grilledbiscuits/smartfeeder/deploy/soak-20261012/README.md

# Pi replay soak, 2026-10-12

This is a **desk replay stability test**, not a field visit or independent
accuracy test. The Pi replays 20 labelled clips through the deployed 37-class
INT8 classifier for 72 cycles at 30-second intervals (1,440 events planned).
The ToF sensor is unpowered; the camera is not used by the replay runner.

- `pilot/`: complete one-cycle check, 20 events, 0 errors. All three files were
  checked before the full run began.
- `checkpoint/`: a snapshot of the **still-running** full soak at 14:31:44 SAST,
  460 events, 0 errors. Do not quote it as a completed 12-hour result.
- `events.jsonl`: one row per event, including processing time, memory, temperature,
  clock, throttle flags, classification, and action outcome.
- `status.json`: run state, counts, and SHA-256 hashes of the model, config,
  calibration, taxonomy, replay manifest, and runner.
- `runner.log`: startup warnings and uncaught errors from the process.

## Completed run

The full soak completed: 1440 events, 0 runtime errors, 1368 correct identifications, and 1440 correct actions. `full/` contains the complete event log, status, and runner log. Repeated clips test stability, not independent accuracy.

Camera latency results and measurement code are in `latency/`. No USB-C power measurement was available from this laptop.
