grilledbiscuits/smartfeeder/YNSJAC001_EEE4022S_Project_Report/2_Preface/1_Acknowledgements.tex

\phantomsection
\prefacesection{Acknowledgements}

% INSERT YOUR ACKNOWLEDGEMENTS %
%I would like to acknowledge my parents and friends. This thesis, a manifestation of the many sleepless nights, would not have been possible without their support. This section highlights your acknowledgment of individuals whom you believe deserve recognition for their contribution towards making your achievement possible.  

\clearpage % keep this for proper page numbering!
