grilledbiscuits/smartfeeder/YNSJAC001_EEE4022S_Project_Report/2_Preface/2_PlagiarismDeclaration.tex

\phantomsection
\prefacesection{Plagiarism Declaration}

    \begin{enumerate}
        \item I know that plagiarism is wrong. Plagiarism is to use another's work and pretend that it is one's own.
        \item I have the IEEE convention for citation and referencing. Each contribution to, and quotation in, this final year project report from the work(s) of other people, has been attributed and has been cited and referenced.
        \item This final year project report is my own work.
        \item I have not allowed, and will not allow, anyone to copy my work with the intention of passing it off as there own work or part thereof.
    \end{enumerate}

    \vspace{15mm}

    \mbox{}\hfill\begin{minipage}{65mm} % No need to change this part
      \dotfill\\[1ex]%
      \Author\\
      \today
    \end{minipage}
    
    \vfill\vfill\vfill
