grilledbiscuits/smartfeeder/YNSJAC001_EEE4022S_Project_Report/5_Appendices/Appendix_B/Appendix_B.tex

\chapter{Satirical Support}

This section provides some comic relief. In addition, it serves as an example of how to insert an image into your thesis with proper caption, label and citation.

\begin{figure}[ht]
	\centering
	
	\caption{You must prepare to defend your thesis.}
	\label{fig:DEFENCE}
\end{figure}

\clearpage
