grilledbiscuits/smartfeeder/ml/ASSUMPTIONS.md

# Assumptions

Things I have assumed, inferred, or could not verify — collected here rather
than buried in comments. **Each needs your confirmation.** Ordered by how much
damage a wrong assumption would do.

Legend: 🔴 blocks or invalidates results · 🟡 shapes design · 🟢 minor

---

## 🔴 A1. The sex head is data-starved, and it is exactly where you said it would hurt

Measured against the live iNaturalist API on 2026-07-31 (research grade, South
Africa, with photos):

| Species | Observations | Male | Female | Sex-annotated |
|---|---|---|---|---|
| *Cinnyris chalybeus* | 6203 | 530 | **161** | 11.2% |
| *Anthobaphes violacea* | 3617 | 885 | 207 | 30.2% |
| *Nectarinia famosa* | 4405 | 606 | 202 | 18.4% |
| *Promerops cafer* | 4701 | 186 | **59** | 5.3% |
| *Chalcomitra amethystina* | 3526 | 591 | 295 | 25.3% |
| *Cinnyris afer* | 3021 | 512 | **108** | 20.5% |

Only 5–30% of observations carry a Sex annotation, and males outnumber females
roughly 3:1 — photographer bias toward bright breeding males.

**Consequence:** after dedup and a grouped split, female *C. chalybeus* and
female *C. afer* yield roughly 16–24 test images each. That is not enough to
settle whether they are separable. The Phase 5 fast loop will report
"insufficient data to decide" for these classes rather than a verdict (D11).

**This is the project's binding constraint — not the architecture.** The
photographs exist; the annotations do not. If you want the merge question
actually answered this round, manually sexing a few hundred existing images is
by far the highest-value use of your time. Phase 5 will quantify exactly how
many per class.

**Please confirm:** should the pipeline include a labelling-assist export
(uncertainty-ranked crops, ready to sex) as part of Phase 5 rather than waiting
for Phase 8?

## 🔴 A2. No source annotates eclipse plumage

The iNaturalist Sex controlled term has exactly three values (Male, Female,
Cannot Be Determined) and Life Stage offers Adult and Juvenile. GBIF's `sex`
field is binary. Wikimedia and Flickr have no structured annotation at all.

I have therefore assumed `male_breeding` vs `male_eclipse` **cannot be sourced
automatically at all**, and implemented the masked partial-label loss (D3)
instead of fabricating labels.

**Please confirm:** is that acceptable, or do you have another source in mind?
The Macaulay Library request (Phase 2) is the realistic route to real plumage
annotations — their media *is* annotated for age and sex — which is why the
draft email matters more than it might appear.

## 🔴 A3. There is a git repository over your entire home directory

`/home/grilledbiscuits/.git` exists with zero commits, and tracks nothing yet.
It looks like an accidental `git init`.

I did not touch it, and gave `smartfeeder/` its own repository instead (D1).

**This is a standing hazard:** a stray `git add -A` run from your home directory
would stage `.ssh/` private keys, `.gnupg/`, `.claude.json`, browser profiles and
Thunderbird mail. **Recommend you delete it** (`rm -rf ~/.git`) once you have
confirmed it holds nothing you want — but that is your call to make, not mine.

## 🟡 A4. GBIF places the Fiscal Flycatcher in *Sigelus*, not *Melaenornis*

`GET /species/match?name=Melaenornis silens` returns `Sigelus silens`, genus
*Sigelus*, matchType EXACT (via synonymy). Family is Muscicapidae either way, so
rollup is unaffected.

I kept **Melaenornis silens** in `species.yaml` — current IOC usage and the name
you supplied — and will record GBIF's own genus separately during resolution.
`taxa.py` will treat a derived-genus/backbone-genus mismatch as a warning
requiring an explicit acknowledgement, not a silent pass.

**Please confirm** you are happy retaining the IOC name.

## 🟡 A5. Rollup thresholds are placeholders

`species: 0.55, genus: 0.65, family: 0.75, guild: 0.80` in `taxonomy.yaml` are
**guesses**, chosen only to be monotonically increasing with generality. They
are not derived from anything.

Phase 7 populates `per_class_thresholds` from real precision-recall curves. Do
not read anything into the current values.

## 🟡 A6. Class-size policy numbers are judgement calls

`min_species_images: 100` (fold into genus), `warn_species_images: 250`,
`min_test_images_for_verdict: 50`. Reasoned but not empirical — the 100 figure
matches the threshold you asked to be flagged in the Phase 2 report.

Under this policy, *A. reichenowi* (33 global) and *C. neergaardi* (32 global)
will certainly fold into `anthreptes_indet`… except *Anthreptes* is a
single-species genus here, so they fold to `nectariniidae_indet` instead. Worth
knowing before you see it happen.

## 🟡 A7. Monomorphic species list is from general ornithological knowledge

`monomorphic_forced_na` in `taxonomy.yaml` lists 13 Tier C species plus both
*Cyanomitra* as visually monomorphic, forcing their sex label to
`not_applicable` so the head is not trained on noise.

This is **my knowledge, not a cited source**. *Cyanomitra veroxii* and
*C. olivacea* in particular are worth a second look — they show subtle
dimorphism that a field guide would list even if a feeder camera could not
resolve it. You are far better placed to check this list than I am.

## 🟢 A8. Local fast-loop backbone choice

`convnext_tiny.in12k_ft_in1k` was chosen as a CPU-feasible compromise. I have
**not** benchmarked its extraction throughput on this machine — the 30–45 min
estimate for 20k images is from your brief, not measured. Phase 5 will measure
it and report the real figure.

## 🟢 A9. `max_images_per_species: 1500`

Caps the head of the distribution so *C. chalybeus* does not swamp training.
Arbitrary. Interacts with class-balanced sampling and focal loss, both of which
Phase 6 reports on, so it can be revisited with evidence.

## 🟢 A10. Augmentation parameters are unvalidated

Motion blur kernel 3–11px, occlusion up to 30% area, JPEG quality 30–75. Chosen
to mimic the deployment failure modes you described. Until real feeder captures
exist there is nothing to validate them against — the domain gap remains the
project's largest technical risk, and these numbers are a hypothesis about it.

---

## 🔴 A11. First real scores: females are worse, but not in the way expected

Vertical slice, 2026-08-01. Tier A only (6 species), 3,573 images after dedup,
linear probe on frozen `convnext_tiny.in12k_ft_in1k` features. Taxon accuracy
**0.684** [95% CI 0.644-0.722]. Test recall broken out by sex:

| Species | Sex | n | Recall | 95% CI |
|---|---|---|---|---|
| *C. chalybeus* | male | 57 | 0.544 | 0.42-0.67 |
| *C. chalybeus* | female | 39 | 0.359 | 0.23-0.52 |
| *C. afer* | male | 63 | 0.667 | 0.54-0.77 |
| *C. afer* | female | 28 | 0.250 | 0.13-0.43 |

The male/female gap is real — the CIs for male and female *C. afer* do not
overlap. But **where the errors go differs by sex**, and that was not expected:

- **Male** errors concentrate on the sibling species (male *chalybeus* → *afer*
  14 of 26 errors; male *afer* → *chalybeus* 14 of 21).
- **Female** errors scatter across all species (female *chalybeus* → *afer* 11,
  *famosa* 7, *amethystina* 5; female *afer* → *chalybeus* 6, *violacea* 5,
  *famosa* 4).

**This matters for the merge decision.** Merging *C. chalybeus* and *C. afer*
into `cinnyris_double_collared_indet` would recover most *male* errors but only
about a third of *female* errors. The female problem is not primarily
sibling confusion — it looks like weak features from drab plumage. **Merging
would not fix it.**

Both female classes fall below `min_test_images_for_verdict: 50`, so the
pipeline correctly refuses to issue a merge verdict. Treat the above as a
direction, not a conclusion.

**Caveats, all of which inflate or deflate this number:**
- Linear probe on ImageNet features, not a fine-tune. A real fine-tune should
  improve absolute accuracy substantially.
- Six classes only. No Tier C, so the false-positive question is untested.
- The corpus over-samples annotated observations (D12), so it is harder than the
  wild distribution — the 0.684 is pessimistic as a deployment estimate and
  meaningless as a class-prior estimate.
- Still web photographs. The feeder-camera domain gap is entirely unmeasured.

---

## 🔴 A12. CORRECTION to A11 — merging the double-collared pair IS now justified

A11 concluded, on 3,573 images, that merging *C. chalybeus* and *C. afer* "would
not fix" the female problem because female errors scattered rather than
concentrating on the sibling. **With 9,318 images that conclusion is wrong and
is withdrawn.**

Measured on `tf_efficientnetv2_b0`, test split:

| | before merge | after merge | gain |
|---|---|---|---|
| overall | 0.727 | 0.786 | +5.9pp |
| **females only** (n=276) | 0.551 | 0.630 | **+8.0pp** |
| males only (n=758) | 0.785 | 0.846 | +6.1pp |

45% of all errors on the double-collared pair are mutual confusion between the
two. Merging now helps females **more** than males, the reverse of A11.

What changed is sample size, not the model. The earlier female error counts
(11 and 6) were too small to distinguish "scattered" from "concentrated"; at
n=48–58 per class the concentration is clear. This is precisely the failure mode
`min_test_images_for_verdict` exists to prevent, and I drew a conclusion from
under-powered data anyway. Treat A11's directional claim as retracted.

**Recommendation:** add `cinnyris_double_collared_indet` as a merged class and
let the rollup emit it when neither species clears its threshold. This is the
brief's "correct outcome, not a failure" case.

## 🔴 A13. *Cinnyris afer* is the single worst Tier A class

Female recall 0.208 (`tf_efficientnetv2_b0`) and 0.167 (`convnext_tiny`), against
0.552/0.621 for female *C. chalybeus*. The errors are overwhelmingly one-way:
female *afer* → *chalybeus* (18 and 23 respectively), not the reverse.

The classifier is collapsing *afer* into *chalybeus*. That asymmetry suggests a
prior/imbalance effect on top of genuine visual similarity, so class-balanced
sampling and focal loss (both already configurable, Phase 6) should be evaluated
against it specifically before concluding the pair is inseparable.

## 🟡 A14. EfficientNetV2 Hailo compatibility is UNVERIFIED

`tf_efficientnetv2_b0` uses fused-MBConv blocks and squeeze-excite. Both are
standard convolutional constructs and should compile, but **I have not run the
Hailo Dataflow Compiler** — it is an x86 toolchain requiring a Developer Zone
account, and is not installed here.

If it turns out SE blocks compile poorly on the Hailo-8L, `efficientnet_b0`
(0.39G MACs, 0.691 taxon) and `mobilenetv3_large_100` (0.21G, 0.690) are the
fallbacks, at roughly -4pp taxon and -4 to -8pp female. Worth compiling all
three early rather than discovering this at deployment.

## 🟡 A15. More data helped substantially — and is probably still helping

Tier A taxon accuracy on `convnext_tiny` went **0.684 → 0.788** when the corpus
grew 3,573 → 9,318 images (+10.4pp for 2.6x data). The curve has not visibly
flattened.

The cap is now `max_images_per_species: 1500`, and several species hit it. Raising
it is the cheapest remaining accuracy lever — cheaper than any architecture
change measured so far — though it will not help the *sex* head, which is
limited by annotation availability, not photograph availability.

---

## 🔴 A16. Adding Tier C cost Tier A accuracy — as expected, and it was worth it

With Tier A alone (6 classes): Tier A macro recall **0.735**, female **0.577**.
With Tier C added (24 classes): Tier A macro recall **0.686**, female **0.471**.

That is −4.9pp on Tier A and −10.6pp on females. The drop is real and is the
price of the model being *able* to say "not a sunbird". The earlier Tier-A-only
number was flattering because the model was never asked to reject anything.

What Tier C buys, measured on the test split:

* Tier C bird called a nectarivore: **9.4%** [7.9–11.1]
* Tier A bird called a non-target: **10.4%** [8.9–12.1]

Worst offender by a distance: **Speckled Mousebird (*Colius striatus*), 40%
called a nectarivore** (n=60). Plausible — long tail and slender body read like a
Cape Sugarbird. Karoo Prinia (18.5%) and Cape Bulbul (17.6%) follow.

**Recommendation:** *Colius striatus* needs more data before deployment; at 40%
it is a live false-positive source at a Cape Town feeder, where mousebirds are
common.

## 🔴 A17. The OOD evaluation set is missing its most common members

`config/ood.yaml` covers animals. Real feeder footage will be dominated by
things iNaturalist cannot supply, because nobody uploads them as wildlife
observations:

* **empty feeder** — by far the most common motion trigger
* **rain, blown leaves, moving shadows, lens flare**
* **human hands and faces** (refilling the feeder; *Homo sapiens* has 0
  research-grade ZA records)

So the 90.9% catch rate is measured against the *animal* subset of the problem
only. It is necessary evidence, not sufficient. **The first week of real capture
data should be used to re-measure this**, and those frames are exactly what the
`unknown` log will collect automatically.

## 🟡 A18. Weakest OOD classes are the ones that matter most at a feeder

Per-taxon catch rate at 5% false alarm:

| taxon | caught |
|---|---|
| Agama atra | 0.982 |
| Trachylepis capensis | 0.974 |
| Rattus rattus / Papio ursinus / Felis catus | 0.955–0.958 |
| Papilio demodocus | 0.952 |
| **Sciurus carolinensis** (grey squirrel) | **0.930** |
| Apis mellifera | 0.916 |
| **Rhabdomys pumilio** (grass mouse) | **0.816** |
| **Xylocopa caffra** (carpenter bee) | **0.794** |

The two weakest are both small animals photographed at flowers — the same
context, scale and background as a feeding sunbird. Carpenter bees in particular
*share the feeder*, so they will be over-represented in real triggers relative to
this evaluation set. Expect the real-world figure to be worse than 90.9%.

## 🟡 A19. The 5% false-alarm rate is a placeholder

`target_false_alarm_rate: 0.05` means 5% of genuine bird frames are discarded as
unknown. End to end that yields: 69.1% of real bird frames trigger capture, 4.0%
of intruder frames do.

This is an operator preference, not a derived value. Track-level voting also
softens it — a visit yields many frames and only needs some to pass. Revisit once
you know whether you would rather miss visits or store squirrels.

---

## 🔴 A20. False triggers are close to solved. Confidence on real birds is not.

**CORRECTED 2026-08-05.** This entry previously claimed 22.9% of bird visits and
0.4% of OOD visits trigger. Those figures were stale: `reports/operating_points.json`
had been regenerated and the prose was never updated. The numbers below are read
directly from that file, at the stated operating point (novelty FAR 15%,
per-class thresholds fitted for 80% precision):

* **OOD visits that trigger a capture: 1.3%.** At 30% FAR it is 0.6%.
* **Real bird visits that trigger a capture: 41.95%** (224 of 534 test visits).

Two things make even that figure hard to interpret, so treat it as an upper
bound on the problem rather than a measurement:

1. **The denominator is contaminated.** `frame_triggers` only checks Tier A
   class thresholds, but the rate is computed over every in-distribution test
   visit. 234 of the 534 (43.8%) are Tier C and cannot fire by construction, so
   the metric's ceiling is 56.2%, not 100%. Against the 300 Tier A visits, 224
   fires is 74.7% — but fired-frame precision is 0.868, so some of those are
   Tier C birds misread as Tier A. The true Tier A trigger rate lies somewhere
   between 42% and 75%.
2. **The metric does not execute production inference.** It fires when any Tier A
   probability crosses its threshold even if that class is not the argmax, and
   it uses "any frame fires" rather than `Classifier.vote()`. `should_record`
   meanwhile fires on *any* species- or genus-level result, including Tier C.

**So the size of this problem is currently unknown.** It is smaller than the
22.9% figure that drove planning through 2026-08-04, and it may not be a problem
at all. Resolving it requires an evaluation path that calls `decide()`, `vote()`
and `should_record` on the real checkpoint. See RUNNING.md.

What the FAR sweep does show clearly is a real trade: moving 2% → 15% FAR costs
6.7pp of bird visits (48.7% → 42.0%) to gain 6.3pp on OOD (7.6% → 1.3%). The
novelty gate and the classifier are competing, and they were fitted
independently. A joint re-tune remains the cheapest available lever.

The cause is that frozen-feature confidence is poor on the hardest classes. At a
90% precision target the double-collared sunbirds only fire on 3–9% of their
frames; relaxing to 80% gets them to 20–37%:

| Tier A species (80% target) | threshold | test precision | recall |
|---|---|---|---|
| Amethyst Sunbird | 0.41 | 0.881 | 0.601 |
| Nectarinia famosa | 0.69 | 0.875 | 0.477 |
| Cinnyris afer | 0.56 | 0.841 | 0.406 |
| Anthobaphes violacea | 0.51 | 0.831 | 0.729 |
| Promerops cafer | 0.32 | 0.759 | 0.811 |
| **Cinnyris chalybeus** | **0.82** | **0.742** | **0.223** |

***Cinnyris chalybeus* is the worst case and also the most likely visitor** —
the commonest sunbird at a Cape Town feeder is the one the model is least
confident about. It cannot reach 80% precision at any threshold, and at 0.82 it
fires on under a quarter of its frames.

**The fix is not more thresholding.** These numbers come from a linear probe on
frozen ImageNet features; the ceiling is set by the features, not the head.

**Confirmed 2026-08-05.** The full fine-tune ran 20 epochs on CPU (5.3 h) and
lifted val taxon accuracy from 0.684 to 0.7875 with Tier A macro-recall 0.7782
at the selected epoch 16. The diagnosis was right: the features were the ceiling.

**But none of the per-class numbers in the table above have been recomputed on
the fine-tuned model.** Until 2026-08-05, `eval/` loaded frozen sweep embeddings
and never read a checkpoint, so re-running it would have reported the pre-fine-tune
model under the new model's name. `eval/extract.py` now exists to close that gap;
this table stands only until it is rerun.

## 🟡 A21. "Highly likely visitor" is not yet encoded anywhere

The range prior exists in `inference.py` and is **empty**. Nothing currently
tells the model that a Cape Town feeder sees six species routinely and
*Cinnyris neergaardi* essentially never.

Populating it would raise precision on the real visitors for free — no
retraining, one config block. It needs your input, though: the weights should
reflect what your feeder actually sees, and I would be guessing. A first pass
could come from iNaturalist observation density within ~25km of the site.

---

## 🔴 A22. INT8 quantisation costs 5.1 accuracy points — not free

Measured 2026-08-04 on 800 test images, against a genuinely trained model
(backbone + frozen-feature heads, standardisation folded into the linear layer).
MinMax calibration, per-channel weights, 500 calibration images from train.

* **24.4 MB → 7.5 MB** (3.3x smaller)
* **accuracy 0.641 → 0.590 (−5.1pp)**
* the two models agree on only 72.2% of test images

Five of six Tier A classes degraded past the 2% flag threshold:

| class | FP32 | INT8 | delta |
|---|---|---|---|
| *Chalcomitra amethystina* | 0.714 | 0.607 | −10.7pp |
| *Anthobaphes violacea* | 0.803 | 0.697 | −10.6pp |
| *Promerops cafer* | 0.820 | 0.746 | −7.4pp |
| *Cinnyris afer* | 0.509 | 0.456 | −5.3pp |
| *Cinnyris chalybeus* | 0.554 | 0.523 | −3.2pp |

This is exactly the failure the brief predicted: nearly-identical classes sit
close together in feature space and INT8 smears them, **unevenly**. An averaged
delta would have hidden that *amethystina* and *violacea* took the worst of it.

**Not yet exhausted.** Only MinMax calibration was measured. Percentile and
Entropy calibration are usually kinder to outlier activations and often recover
much of the loss; that comparison was started and interrupted, and is the first
thing to finish. Mixed precision — keeping the final layers in FP32 — is the
next lever after that.

**Do not ship INT8 on these numbers.** If the board turns out to be a Pi 5 with
the AI HAT+, quantisation is mandatory anyway and this becomes a hard constraint
to engineer around. If it is a Pi 4B, it is a speed/accuracy dial you control.

## 🟡 A23. The first export with real weights was only just now possible

Every earlier ONNX export carried **randomly-initialised heads** — the graph was
valid, the cost figures were real, but the predictions were noise. Quantising it
measured noise against noise, which I caught only when the reported accuracy came
back at 0.05.

`export_from_frozen_head` now builds a genuinely trained model from the fast-loop
heads, folding the feature standardisation into the linear layer. Anything that
evaluates the exported artefact must use that path until `train_full.py` exists.

## 🔴 A24. RESOLVED — INT8 costs 3–5 accuracy points, and calibration cannot fix it

The matched sweep is done: identical 800-image evaluation set, varying only
calibration size, Percentile calibration.

| calibration images | FP32 | INT8 | delta | INT8 95% CI |
|---|---|---|---|---|
| 32 | 0.6412 | 0.6075 | **−3.4pp** | 0.573–0.641 |
| 64 | 0.6412 | 0.5988 | **−4.2pp** | 0.564–0.632 |
| 500 (MinMax) | 0.6412 | 0.5900 | **−5.1pp** | — |

**Calibration size is not the explanation, and neither is method.** Across 32 to
500 calibration images and across MinMax and Percentile, INT8 costs between 3.4
and 5.1 points. There is no setting in this range that makes it free.

**The +1.6pp result was small-sample noise.** It came from a 250-image
evaluation, where the 95% CI spans roughly ±6 points — wide enough to swallow the
entire effect. Measured on 800 images the same configuration gives −3.4pp. That
is a cautionary result about my own earlier reporting, not about the method.

**Consequence for deployment.** INT8 is a real 3–5 point cost, not a free
optimisation:

* **Pi 5 + AI HAT+** — quantisation is mandatory, so this is a cost to engineer
  around, not a choice. Quantisation-aware training or keeping the final layers
  in higher precision are the remaining levers.
* **Pi 4B (CPU)** — it is a dial you control. Given that only ~23% of genuine
  bird visits currently clear a threshold (A20), spending another 3–5 points on
  speed is probably the wrong trade until confidence improves.

Not attempted: mixed precision, and quantisation-aware training. Both are real
options and both are more work than a calibration flag.

## 🟢 A24b. Superseded note — the original uncertainty

Two runs, not comparable:

| run | calib images | test images | delta |
|---|---|---|---|
| first | 500 | 800 | −5.1pp |
| second | 64 | 250 | −0.8 to +1.6pp |

They differ in **both** variables, so neither explains the gap. And at n=250 the
95% CIs across the three calibration methods overlap almost completely, so that
sweep cannot rank them either.

What would settle it: one evaluation set (ideally the full 2,674 test images),
varying only calibration size, one method per process. That is roughly six
short runs and was not attempted here because each earlier long run was being
OOM-killed. It is now safe to do with the memory guard in place.

Until then, treat INT8 as "probably cheap, possibly costly" and re-measure
before shipping.

## 🔴 A25. Fine-tuning improved classification and *broke* open-set detection

Measured 2026-08-05 on `student_best.pt` (epoch 16), test set n=2,674 in-distribution
and 2,486 OOD, via `eval/extract.py` + `eval/thresholds.py --checkpoint`.

**Classification improved on every axis.** Temperature fell from 2.332 to **0.986** —
the fine-tuned model is essentially calibrated as trained and needs almost no
softening. Per-class recall at the 80% precision target:

| Tier A species | frozen recall | fine-tuned recall | frozen prec | fine-tuned prec |
|---|---|---|---|---|
| Amethyst Sunbird | 0.601 | **0.853** | 0.881 | 0.800 |
| Orange-breasted Sunbird | 0.729 | **0.921** | 0.831 | 0.847 |
| Malachite Sunbird | 0.477 | **0.770** | 0.875 | 0.830 |
| Cape Sugarbird | 0.811 | **0.917** | 0.759 | 0.729 |
| *Cinnyris afer* | 0.406 | **0.641** | 0.841 | 0.781 |
| ***Cinnyris chalybeus*** | 0.223 | **0.386** | 0.742 | **0.833** |

A20 said *C. chalybeus* "cannot reach 80% precision at any threshold". It now
reaches 0.833 at threshold 0.74, with recall up 16pp. That was the headline
problem class and it is substantially better.

**Open-set detection degraded badly.** The kNN novelty scorer refitted on
fine-tuned features:

| scorer | frozen AUROC | fine-tuned AUROC |
|---|---|---|
| kNN | **0.979** | **0.9032** |
| energy | 0.9273 | 0.8318 |
| mahalanobis | — | 0.8752 |
| max_softmax | 0.7139 | 0.7912 |

kNN's catch rate at 5% FPR fell from 0.909 to 0.431. Only max_softmax improved,
and only because the model is now calibrated.

This is representation collapse, and it is expected in hindsight: fine-tuning
specialises the feature geometry to the 22 trained classes and discards the
generic visual structure that made a distance-based novelty test work. The
scorer ranking is unchanged — kNN is still best of the four — but its absolute
performance is not what the deployment assumed.

**End to end this was nearly a wash**, at 15% FAR: bird visits 41.95% → 51.1%,
but OOD visits 1.3% → **11.1%**. Nine points of real birds bought at the price
of ten points of squirrels, against a stated priority of minimising false
triggers.

### The fix is measured and works: split the two jobs

Novelty on **frozen** ImageNet features, classification on the **fine-tuned**
model. Same corpus, same thresholds, same scorer — only the feature space the
kNN sees changes:

| novelty FAR | bird visits (FT feats) | OOD visits (FT feats) | bird visits (FROZEN feats) | OOD visits (FROZEN feats) |
|---|---|---|---|---|
| 5% | 0.560 | 0.274 | **0.569** | **0.061** |
| 10% | 0.530 | 0.163 | **0.549** | **0.020** |
| 15% | 0.511 | 0.111 | **0.521** | **0.015** |
| 20% | 0.485 | 0.056 | **0.496** | **0.011** |

**Better on both axes simultaneously at every operating point.** Against the
original frozen-everything baseline at 15% FAR, the hybrid gives 52.1% of bird
visits versus 41.95% — **+10.2pp** — at 1.5% OOD versus 1.3%, which is inside noise.

**Unresolved: this costs two backbone passes on the Pi.** Both are
`tf_efficientnetv2_b0`, one ImageNet-pretrained and one fine-tuned, so it is
2× inference. Untested cheaper option: tap an *intermediate* block of the
fine-tuned network for the novelty features, since early layers retain generic
structure. One forward pass, no second model. That experiment has not been run.

## 🔴 A26. The exported ONNX and the configured thresholds are different models

Found by external audit, verified 2026-08-11.

`ml/data/export/birdcam_student.json` describes the exported graph as:

```json
"training": "frozen-feature linear heads, standardisation folded in",
"feature_file": "tf_efficientnetv2_b0.in1k_18146.npy"
```

written 12:12 on 2026-08-04. The fine-tune that produced `student_best.pt`
finished at 23:21 the same day, and `config/taxonomy.yaml` now carries
per-class thresholds fitted against checkpoint `a71e95cca471`.

**Shipping the current `data/export/` alongside the current config would apply
fine-tuned thresholds and temperature to a frozen-feature model.** Both
artefacts are individually valid, which is what makes the pairing dangerous:
nothing fails, the numbers are simply wrong.

The INT8 export (`birdcam_student_int8.onnx`, 17:45) has the same problem —
it was quantised from the frozen FP32 graph, so the 3–5pp INT8 penalty in A24
is also a measurement of the superseded model.

### Required before any deployment

1. Re-export from `student_best.pt` and stamp the checkpoint SHA into the
   sidecar, exactly as `write_thresholds_to_config` now stamps `taxonomy.yaml`.
   Provenance in one artefact and not the other is how this happened.
2. Re-run quantisation against that export; treat A24's INT8 figures as
   pending until then.
3. The deployment bundle still cannot reconstruct the open-set failsafe: the
   ONNX graph emits only `taxon_logits` and `sex_logits`, and the kNN scorer
   needs the 1,280-d pooled features plus its reference vectors and threshold,
   none of which are serialised. See A25 — which also establishes that those
   features should come from the *frozen* backbone, not the fine-tuned one.

`data/` is gitignored, so this entry is the only durable record that the
export on disk is stale.

## 🔴 A27. First contact with real footage: the model under-triggers, badly

Measured 2026-08-17 on 11,050 frames extracted from 155 minutes of feeder
video (one feeder, one day), scored with `student_best.pt`, the fitted
per-class thresholds and the kNN novelty gate at 15% FAR.

**These are not accuracy figures.** Folder names are clip-level claims and
frames may hold two birds or none. See `data/field.py`.

| folder | n | top prediction | share | would record | flagged unknown |
|---|---|---|---|---|---|
| amethyst | 25 | *C. amethystina* | 100.0% | 100.0% | 0.0% |
| capebulbul | 160 | *P. capensis* | 98.1% | **0.0%** | 1.9% |
| capewhiteeye | 769 | *Z. virens* | 82.2% | 8.2% | 7.4% |
| juvenileamethyst | 192 | *C. amethystina* | 83.9% | 85.4% | 12.0% |
| doublecollared | 2316 | *C. chalybeus* | 39.8% | 55.2% | 17.3% |
| uncut | 7588 | unknown | 60.8% | 15.7% | 60.8% |

### The headline

A hand count of 24 random uncut frames found **10 with a bird and 14 empty**
— roughly 42% bird-present (95% CI ≈ 24–61%). Against that, **15.7% of the
timeline would commit video.**

So on real footage the system is **missing most birds, not recording
squirrels.** Every false-trigger number in this repo came from web
photographs, and they pointed the wrong way. This is the same under-trigger
problem A20 describes, confirmed in the deployment domain.

### The capture allowlist works

Cape Bulbul: 98.1% correctly identified, **0.0% recorded**. A Tier C bird
recognised and deliberately not stored, on real data — exactly what the
allowlist fix (2026-08-11) was for. Cape White-eye still leaks 8.2%, mostly
via `cinnyris_indet` (6.4%), which is on the allowlist by design.

### The negative classes are dead, and novelty is covering for them

Across 126 minutes of mostly-empty feeder, the model called a negative class
**0.0% of the time**. `empty_feeder` has never had a positive training example,
so an empty feeder is instead absorbed by the novelty scorer: 60.8% of uncut
frames are flagged unknown, which tracks the ~58% that are empty.

The open-set failsafe is currently doing the job of the untrained negative
classes. It works, but it is the wrong mechanism — an unreliable distance test
standing in for a class that could simply be trained. This footage supplies
those examples for the first time.

### The domain gap is real but narrow

Max-softmax confidence: field **0.694** (median 0.667) vs web test **0.775**
(median 0.840). Novelty: **46.1%** of field frames sit above the OOD
threshold, against 15% by construction on web data. The feature space treats
real feeder frames as substantially more novel than the photographs it was
fitted on — consistent with A25, and an argument for refitting the novelty
scorer on field data before deployment.

### Double-collareds confirm the merge

Only 39.8% of that folder predicts *C. chalybeus*; 17.3% unknown, 11.7%
abstain, 8.5% `cinnyris_indet`. Worst class on web data, worst class here.

## 🔴 A28. Every frame this project has recorded was out of focus

Camera Module 3 (`imx708`) is an autofocus module, and picamera2 leaves it in
`AfMode.Manual` at `LensPosition 1.0` — **one metre** — unless something sets
it. Nothing in `capture/`, `ml/config/` or `deploy/` referenced focus at all
until 2026-10-09. The perch is at **0.114 m**, measured by running continuous
AF against a target there and reading the lens back (stable median 8.80
dioptres over a 40 s window, corroborated by the ToF ranging the same target at
10–12 cm).

So every clip recorded through this camera — including the field footage the
model was fine-tuned and calibrated on — was focused about **nine times past
the subject**.

The damage is not only sharpness. Blur reads as *unfamiliar* to the energy
novelty gate, so it was rejecting real birds. Measured on one camera, same
scene:

| condition | per-frame energy | clip novelty | frames clearing −4.9434 |
|---|---|---|---|
| blurred Cape White-eye (confirmed visit) | −2.75 … −5.74 | −4.0903 | 2 of 12 |
| sharp hand | −4.29 … −5.65 | −4.961 | 6 of 12 |
| sharp Southern Double-collared | — | −6.883 | cleared by ≈1.9 |

**This supersedes the reading of A25/A27 that the open-set threshold itself was
wrong.** It was reporting blur honestly. Fixed by `camera.lens_position: 8.8`.

Consequence for the model, not yet addressed: the per-class thresholds, the
energy threshold and the INT8 quantisation calibration were all fitted on
blurred field frames or on phone video of a different scene. None of them has
been fitted against what this camera now produces.

## 🔴 A29. The ToF trigger was calibrated against a hand, and missed real birds

The VL53L1X region of interest was narrowed to `4x4` to exclude the feeder
bottle, which sits **nearer the sensor (9–13 cm) than the perch (~20 cm)** — and
because the sensor returns one dominant distance per reading, a nearer permanent
object masks the perch outright.

`4x4` spans about **1.4 cm** at 0.114 m. It was validated against a human fist,
which fills that window; a sunbird does not. Observed outcomes, 2026-10-09:

| `roi_size` | empty-port triggers | observed wild visits |
|---|---|---|
| 4 × 4 | 0 in 3 min | **1 missed** |
| 8 × 8 | 0 in 11 min | 1 caught, **1 missed** |
| 16 × 16 | 3 admitted + 1 dropped in 2 min | — |

Settled on the full array, because the errors are not comparable in cost: every
16×16 empty-port trigger was scored `unknown` and **retained, never published**,
whereas a missed visit is unrecoverable *and silent* — no log line is emitted at
all. Narrowing puts precision in the sensor, which is the wrong layer; the
classifier and allowlist are the precision filter.

Two generalisations worth keeping: **never calibrate the trigger against a proxy
target**, and the system **cannot detect its own misses** — all three false
negatives were found by a human watching the feeder, never by the logs.

## 🟡 A30. The open-set gate does not reject a human hand

A hand at the perch, in focus, published as `nectariniidae_indet` at **0.844**
family confidence with novelty **−4.961**. That clears both the fitted
(−4.9434) and the temporarily loosened (−3.5) threshold, so it is not an
artefact of the test setting.

Measured once, deliberately, under controlled conditions. It bounds what the
energy failsafe can be claimed to do: it catches the empty feeder and a wrongly
aimed camera (14 clips of a misaimed scene on 2026-10-06, all correctly
rejected), but it does not separate a warm close object from a bird.

Clip retained at `var/evidence-20261009/20261009_141436_fd186dd4.mp4`; the
false visit row was deleted from `feeder.db`.

## 🟢 A31. Power consumption is not measurable on this hardware

A Pi 4B has no onboard power sensor, so watts are unobtainable in software at
any sample rate. `vcgencmd measure_volts core` reports the SoC core rail, not
input power, and `get_throttled` only indicates whether the 5 V input sagged
past the undervoltage threshold.

Any power figure in the report must come from an **inline USB-C power meter**.
`deploy/telemetry.py` logs thermal, throttle, clock, CPU and memory from
2026-10-09 onward and says this in its docstring; nothing in that CSV is a power
measurement.

Measured for reference, one record-classify-publish cycle: **+2.9 °C
(48.7 → 51.6), +37.8 MiB RSS, +6.0 pp CPU**, no throttling.

## A32 — the ToF trigger used an absolute range against a perch bolted in the beam

`motion.detection_range_mm: 500` asks "is anything within 50 cm?" and the perch
answers yes permanently, so the gate latched on the first poll and birds landing
on it produced no rising edge. **This supersedes A29** (read then as a
calibration error against a fist proxy) and the ROI findings that followed from
it: narrowing the ROI "fixed" the empty-port triggers by aiming away from the
place birds land, and the `max_hold_seconds` valve became the only thing
admitting detections, on a 60 s timer unrelated to the birds.

Replaced 2026-10-09 by `motion.baseline_margin_mm`: learn the resting distance
of the empty scene, fire on a departure of >= margin in either direction. Same
model as the camera's `IdleBackgroundGate`.

**The margin is unfitted.** 20 mm is a starting value against a resting read
recorded as a rock-steady 13 cm. `deploy/tof_baseline.py` fits the lower bound
(largest margin with no empty-port trigger) and has not been run: the Pi was
unreachable. The upper bound -- the largest margin that still catches a perched
sunbird -- needs a bird on the perch and is not measurable from a trace.
Quote no detection rate until both are measured.

## A33 — Greater Double-collared's fitted threshold is unusable; held at the default

The 2026-09-21 refit emitted `cinnyris_afer: 0.05` from **n = 48** validation
predictions, the thinnest support of any Tier A class by a factor of four. At
that support the precision curve is lumpy and "lowest threshold reaching 80%
precision" landed on the floor of the sweep; the 0.813 precision beside it is
not a meaningful figure.

A 0.05 species threshold is the worst available error here. Any clip spreading
probability across *Cinnyris* publishes as Greater Double-collared rather than
rolling up to `cinnyris_indet` — and *C. afer* is the confusable congener of
*C. chalybeus*, the common visitor at this feeder, while being itself uncommon
in an urban Cape Town garden. The failure would be a run of false records of
the rarer species, in the one genus the project most needs to get right.

Held at the species-tier default **0.55** (2026-10-10), flagged UNFITTED in
`taxonomy.yaml`. Two `ml/tests/test_inference.py` genus-fallback tests pin this:
they failed from 2026-10-09 (`d6eb066`) until the value was reverted, and were
missed because only the `capture/` subset was run after that refit. **Run the
whole suite after touching `taxonomy.yaml`** — it is read at runtime, so a bad
value there changes labels silently.

Refit needs real support for this class. Do it in the same pass as the
`calibrate_capture` refit against the corrected camera (A28).

## A34 — a bird at the port reads FARTHER than the ToF baseline, not nearer

Measured 2026-10-10. **Every departure logged that day was positive**, with no
exceptions: +11, +13 and +38 mm. The two cleanest are Amethyst Sunbird visits
measured against a baseline independently corroborated at 117–118 mm:

| visit | reading vs baseline | departure | confidence |
|---|---|---|---|
| 25, 10:42:36 | 128 vs 117 mm | **+11 mm** | 0.807 |
| 26, 10:43:35 | 134 vs 121 mm | **+13 mm** | 0.714 |

**Both are operator-confirmed**, 59 s apart. They may be one individual
returning rather than two independent visits, so they are two correct publishes
and not necessarily two visits.

The 2026-10-09 hand test agrees at +11 mm. The resting return is the near
furniture, and a body at the port scatters the beam so the dominant return
comes from behind it.

An earlier version of this entry cited +11/+13 mm figures attributed to a Cape
White-eye and a Cape Bulbul, taken while the baseline was itself moving. Those
did not support the claim; the table above replaces them and does.

This contradicts the assumption written into `capture/motion.py` when the
baseline trigger was built ("a bird perching reads NEARER than the bare rod"),
which was a guess. The symmetric margin was kept only because the direction had
not been measured; had the proposed nearer-only optimisation been applied, it
would have missed both birds above.

**Consequence for the margin.** A confirmed bird clears the fitted 10 mm margin
by **1–3 mm** — measured, not inferred — while the empty-scene wind tail reaches
+11 mm. Wind and birds occupy the same band on the far side, so the margin
cannot be raised without losing visits. This is a standing limit of the ToF
trigger, not a tuning deficit, and the remedy is mechanical (stop the furniture
moving) or a different sensing geometry. Both bounds should be refitted from the
departure log as observer-confirmed visits accumulate.

**Open question, not a finding.** Across the busy 70 s spanning both visits the
baseline rose 117 → 121 → 127 mm. A 120 s median absorbs occupied readings when
occupancy is high, which raises the bar for the next bird — the mirror of the
3 s window's fault. It is unquantified, it needs a trace across sustained
activity, and nothing on the Pi has been changed for it.

**Also: the two fits before this one were measured with a broken instrument.**
`deploy/tof_baseline.py` reimplemented the trigger state machine in its replay
loop and omitted the `max_hold_seconds` valve, so the replayed gate latched and
reported 1 event for every margin from 5 to 15 mm. The 7 mm deployed on
2026-10-09 and the 20 mm recommended on 2026-10-10 are both artifacts. The
replay now drives the real `poll_once` and a test pins it. When a replay and a
live service disagree by 6x, the replay is the thing to doubt first.
