grilledbiscuits/smartfeeder/cad/cradle/cradle_exploded.png

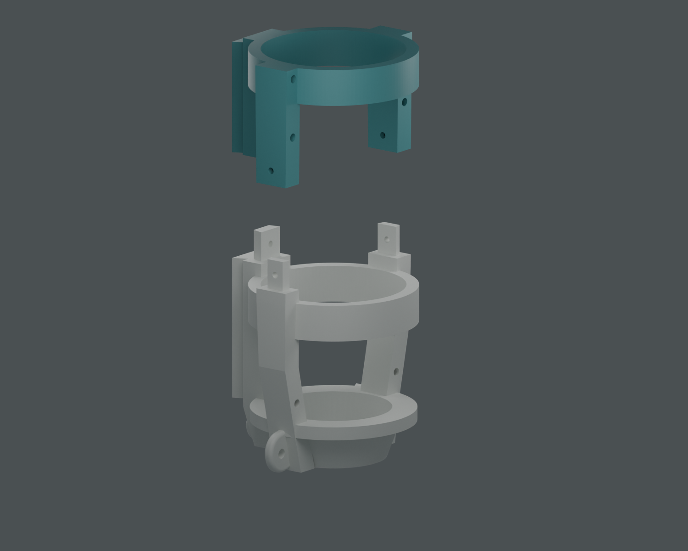
cad/cradle/cradle_exploded.png
