grilledbiscuits/smartfeeder/cad/cradle/cradle_isometric_exploded.png

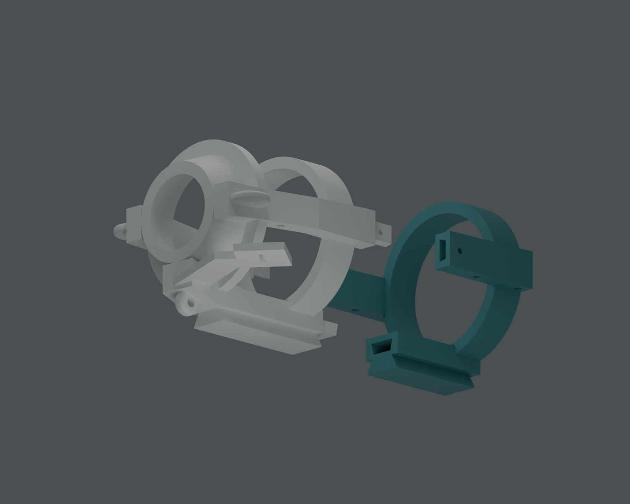
cad/cradle/cradle_isometric_exploded.png
