grilledbiscuits/smartfeeder/cad/docs/camera_housing_draft.png

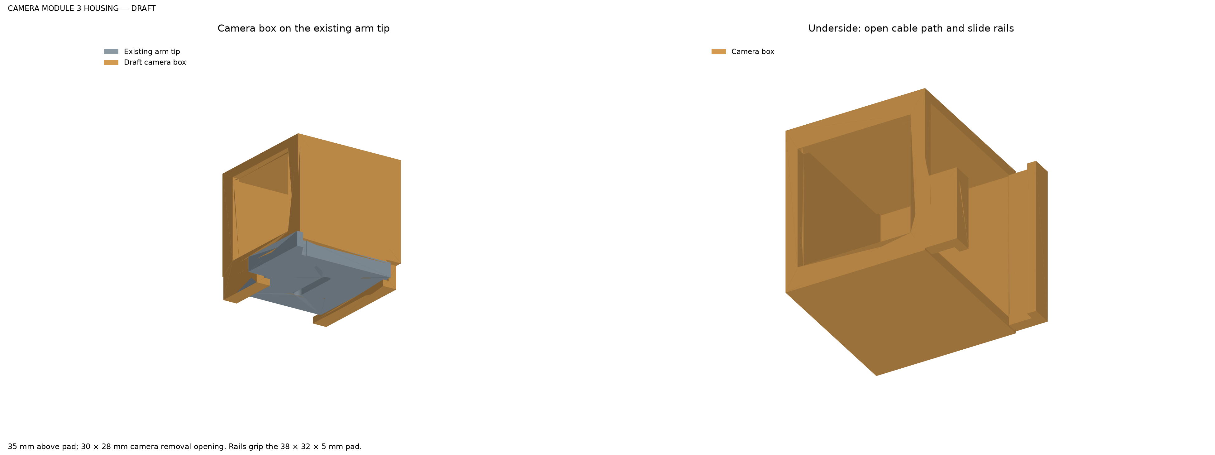
cad/docs/camera_housing_draft.png
