grilledbiscuits/smartfeeder/cad/docs/pi_housing_exploded.png

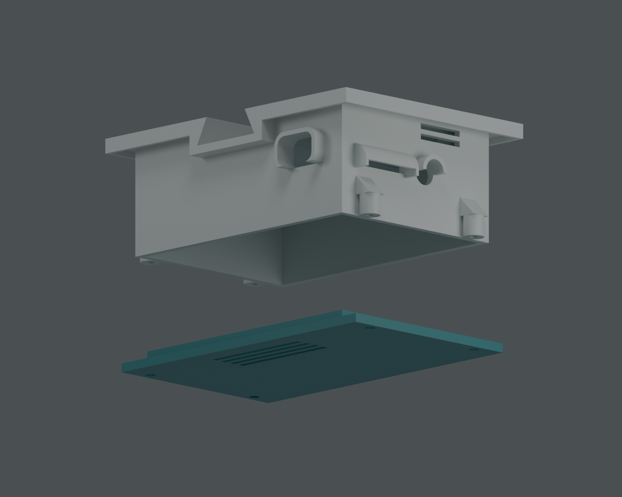
cad/docs/pi_housing_exploded.png
