grilledbiscuits/smartfeeder/cad/docs/pmu_housing_combined.png

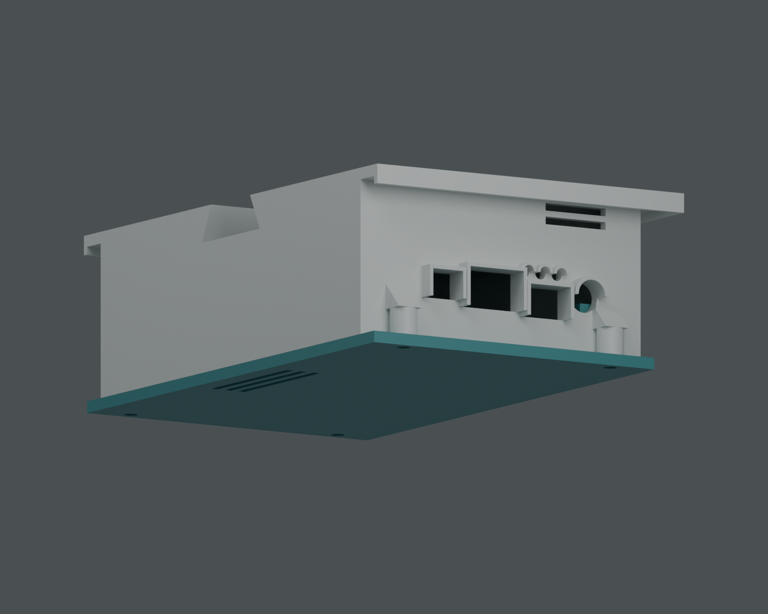
cad/docs/pmu_housing_combined.png
