grilledbiscuits/smartfeeder/cad/docs/pmu_housing_exploded.png

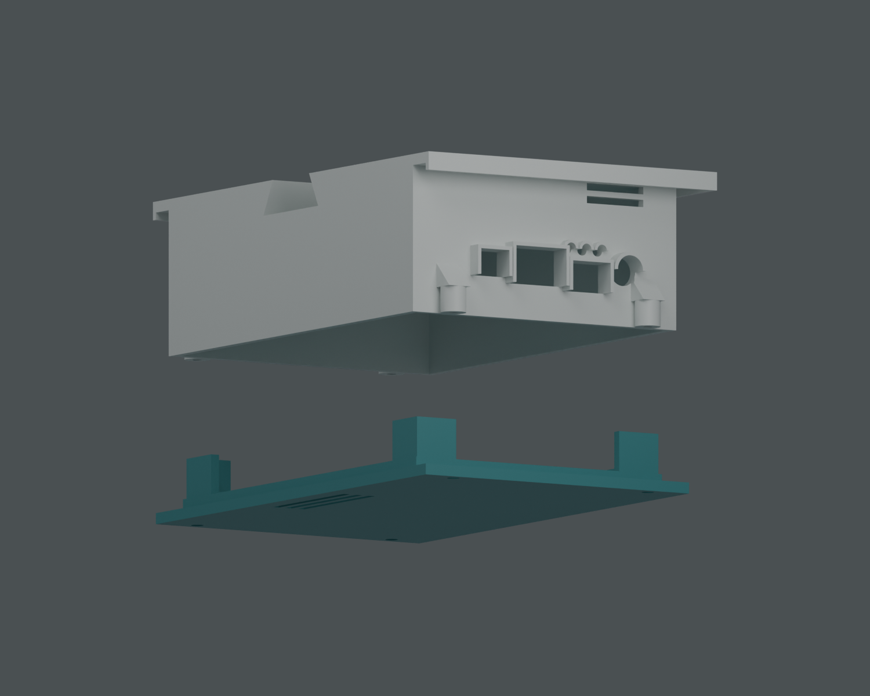
cad/docs/pmu_housing_exploded.png
