grilledbiscuits/smartfeeder/cad/rpi_housing/pi_housing_combined.png

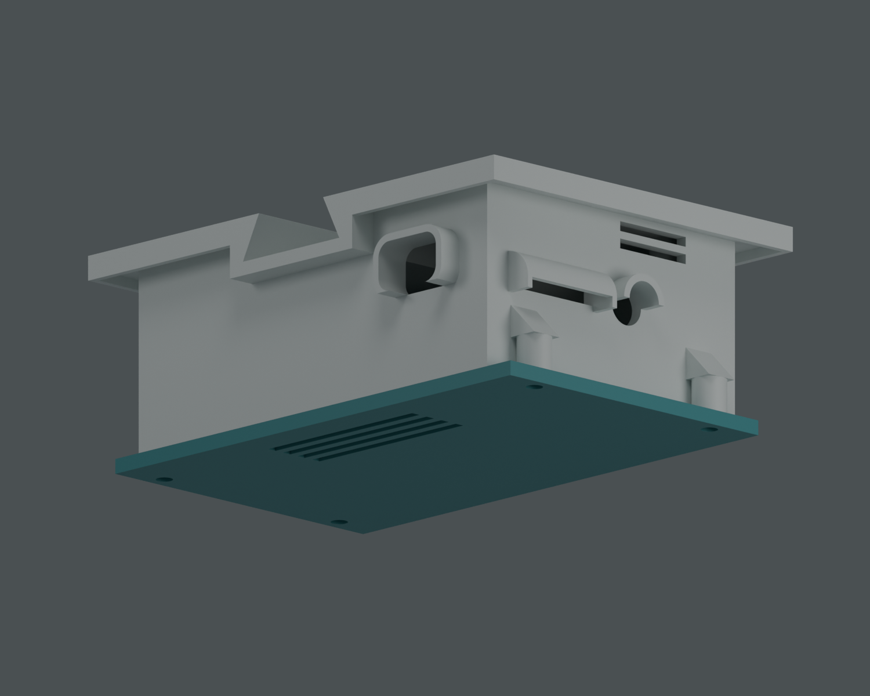
cad/rpi_housing/pi_housing_combined.png
