grilledbiscuits/smartfeeder/cad/tof_housing/tof_housing_draft.png

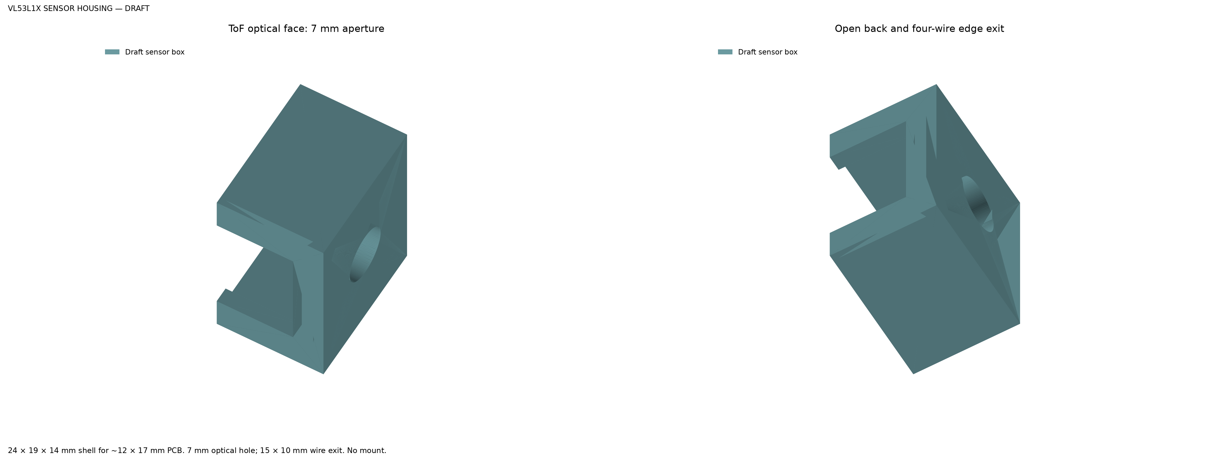
cad/tof_housing/tof_housing_draft.png
