grilledbiscuits/smartfeeder/cad/camera_housing/camera_housing.stl

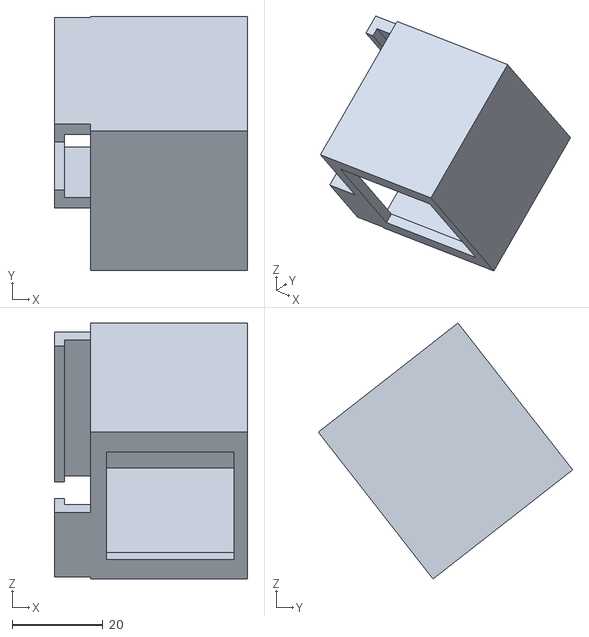
[picture p9: CAD file, 2026-10-14]
cad/camera_housing/camera_housing.stl
42.5 x 56.0 x 56.3
