grilledbiscuits/smartfeeder/cad/cradle/cross_pin_spine.step

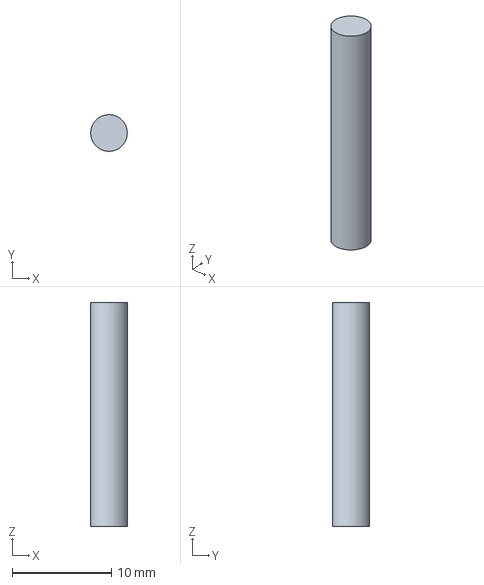
[picture p10: CAD file, 2026-10-14]
cad/cradle/cross_pin_spine.step
3.70 x 3.70 x 22.6 mm
