grilledbiscuits/smartfeeder/cad/pmu_housing/pmu_port_test_wall.step

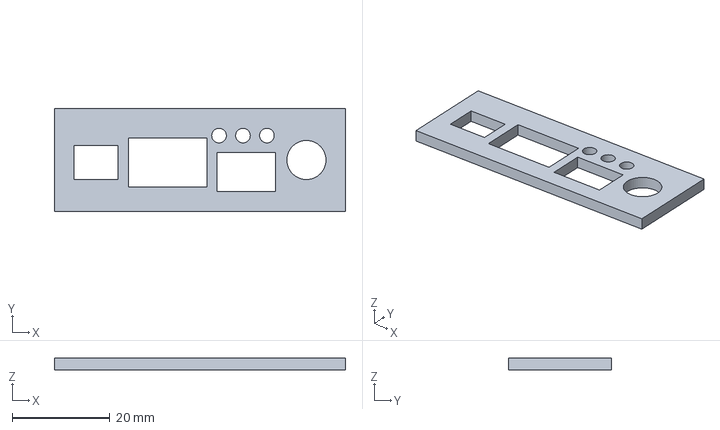
[picture p11: CAD file, 2026-10-14]
cad/pmu_housing/pmu_port_test_wall.step
59.6 x 21.0 x 2.50 mm
