grilledbiscuits/smartfeeder/cad/rpi_housing/rpi_housing.stl

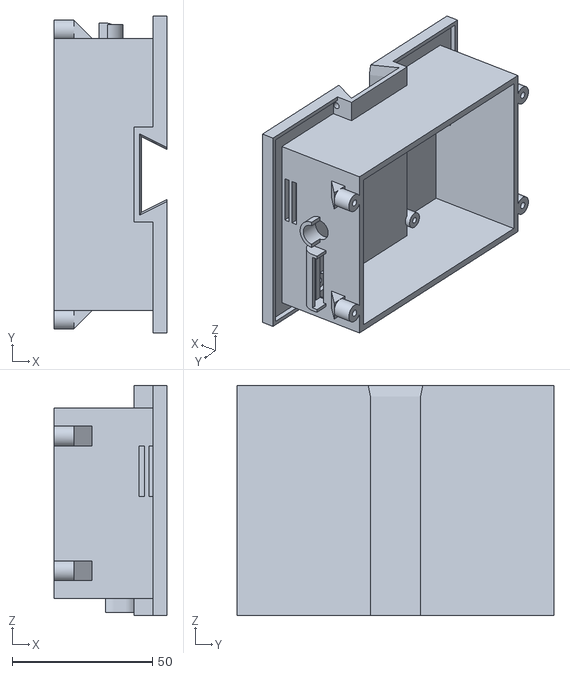
[picture p12: CAD file, 2026-10-14]
cad/rpi_housing/rpi_housing.stl
40.2 x 113.0 x 82.0
