grilledbiscuits/smartfeeder/cad/solar_panel_frame/solar_panel_frame_exploded.step

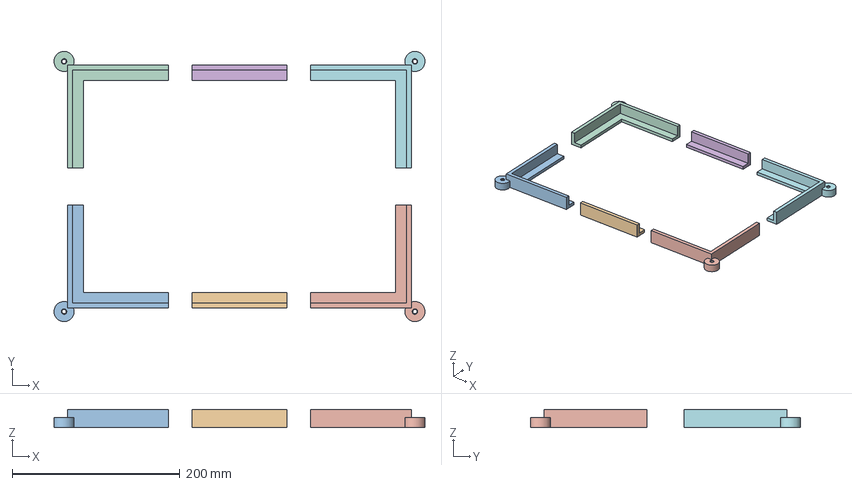
[picture p13: CAD file, 2026-10-14]
cad/solar_panel_frame/solar_panel_frame_exploded.step
442.0 x 322.0 x 22.0 mm
left_lower
left_upper
center_lower
center_upper
right_lower
right_upper
