grilledbiscuits/smartfeeder/cad/step/pmu_housing_lid.step

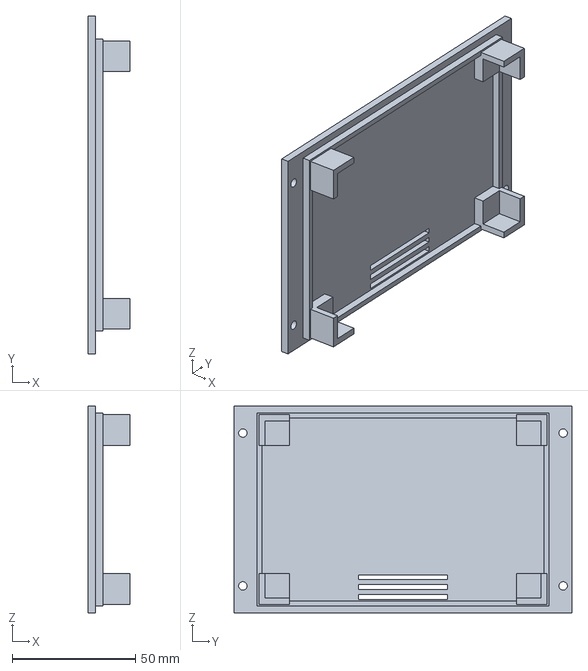
[picture p14: CAD file, 2026-10-03]
cad/step/pmu_housing_lid.step
17.0 x 137.0 x 84.0 mm
