grilledbiscuits/smartfeeder/cad/stl/tof_housing_face_down.stl

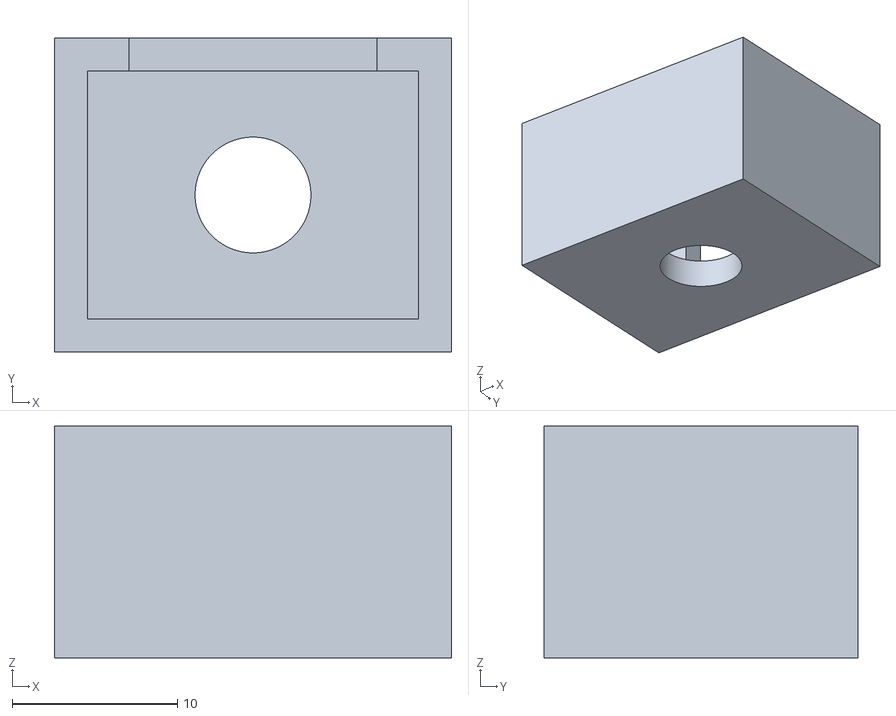
[picture p15: CAD file, 2026-10-03]
cad/stl/tof_housing_face_down.stl
24.0 x 19.0 x 14.0
