grilledbiscuits/smartfeeder/cad/pmu_housing/pmu_housing.stl

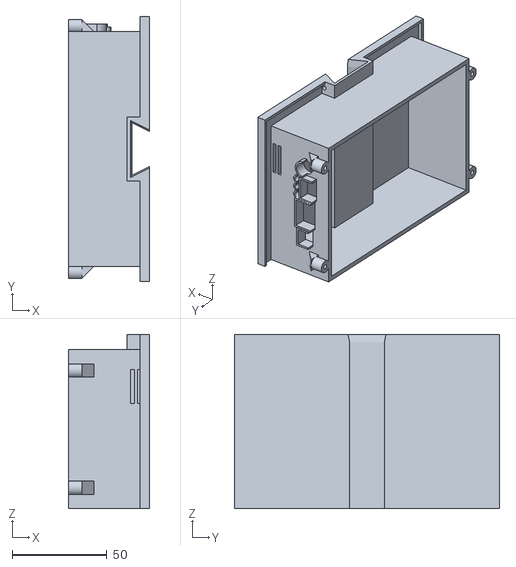
[picture p16: CAD file, 2026-10-14]
cad/pmu_housing/pmu_housing.stl
42.8 x 140.0 x 92.0
