grilledbiscuits/smartfeeder/cad/solar_panel_frame/solar_panel_frame_plate_1.step

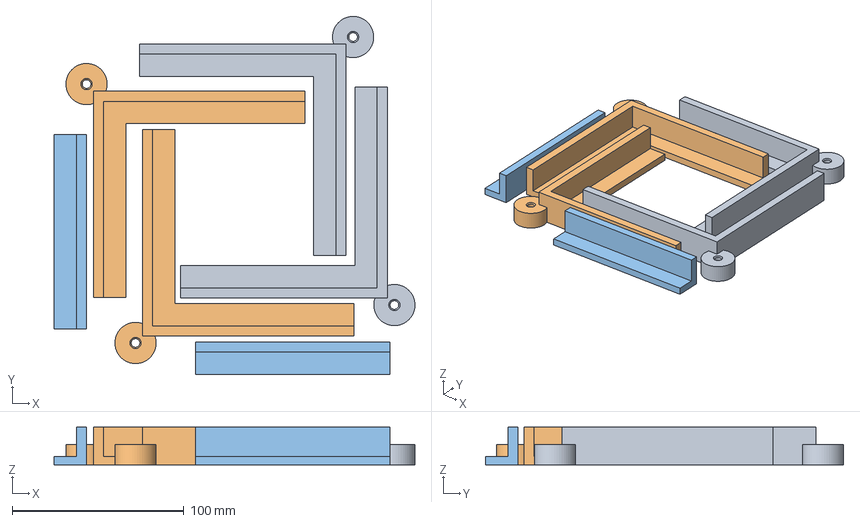
[picture p17: CAD file, 2026-10-14]
cad/solar_panel_frame/solar_panel_frame_plate_1.step
210.1 x 208.4 x 22.0 mm
solar_panel_frame_left_lower
solar_panel_frame_left_upper
solar_panel_frame_right_lower
solar_panel_frame_right_upper
solar_panel_frame_center_lower
solar_panel_frame_center_upper
