grilledbiscuits/smartfeeder/cad/step/cross_pin_beam.step

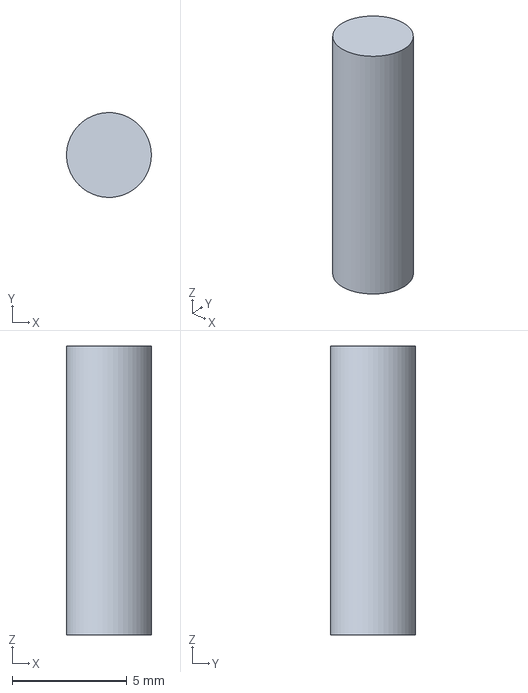
[picture p18: CAD file, 2026-10-02]
cad/step/cross_pin_beam.step
3.70 x 3.70 x 12.6 mm
