grilledbiscuits/smartfeeder/cad/stl/camera_housing_lens_down.stl

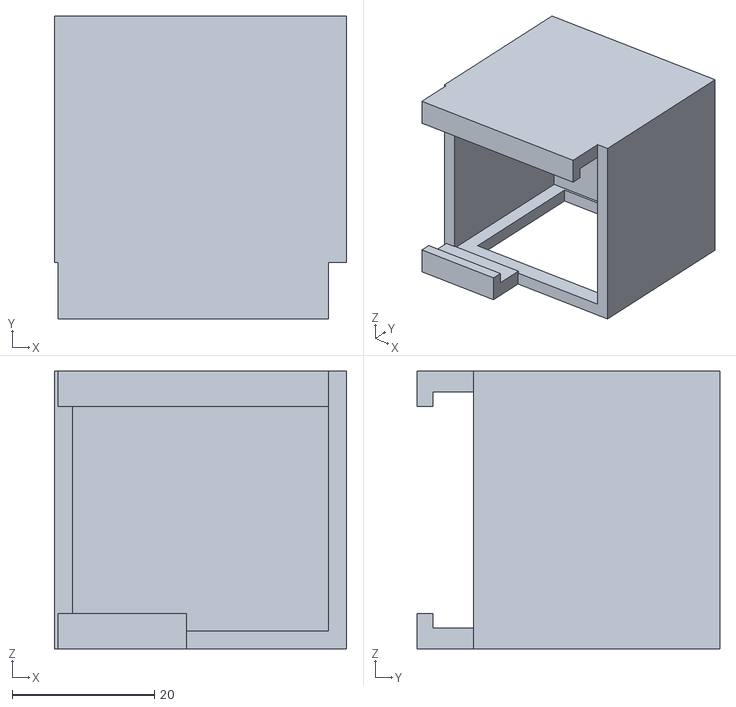
[picture p19: CAD file, 2026-10-03]
cad/stl/camera_housing_lens_down.stl
41.0 x 42.5 x 39.0
