grilledbiscuits/smartfeeder/cad/solar_panel_frame/solar_panel_frame_center_lower.step

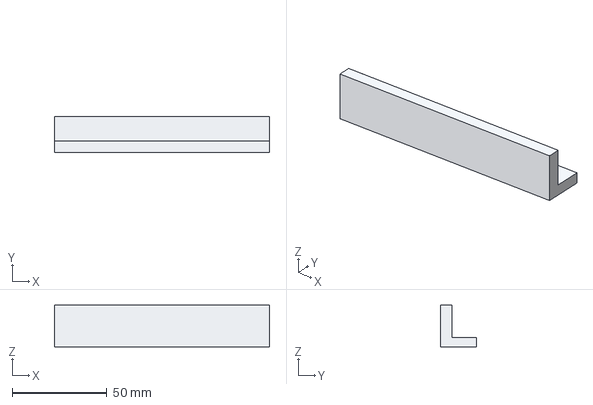
[picture p20: CAD file, 2026-10-14]
cad/solar_panel_frame/solar_panel_frame_center_lower.step
113.3 x 19.0 x 22.0 mm
