grilledbiscuits/smartfeeder/cad/solar_panel_frame/solar_panel_frame_left_upper.step

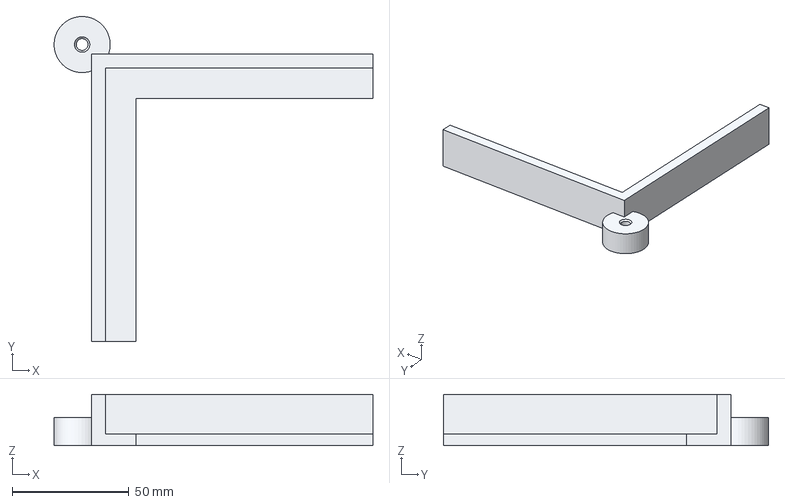
[picture p21: CAD file, 2026-10-14]
cad/solar_panel_frame/solar_panel_frame_left_upper.step
136.3 x 139.0 x 22.0 mm
