grilledbiscuits/smartfeeder/cad/stl/rpi_housing_lid.stl

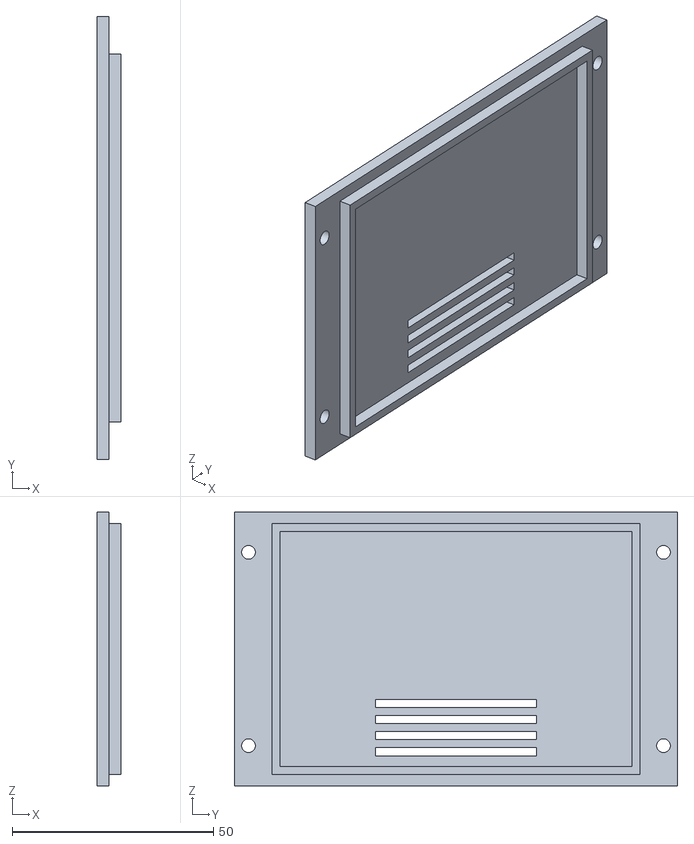
[picture p22: CAD file, 2026-10-02]
cad/stl/rpi_housing_lid.stl
6.00 x 110.0 x 68.0
