grilledbiscuits/smartfeeder/cad/solar_panel_frame/solar_panel_frame.step

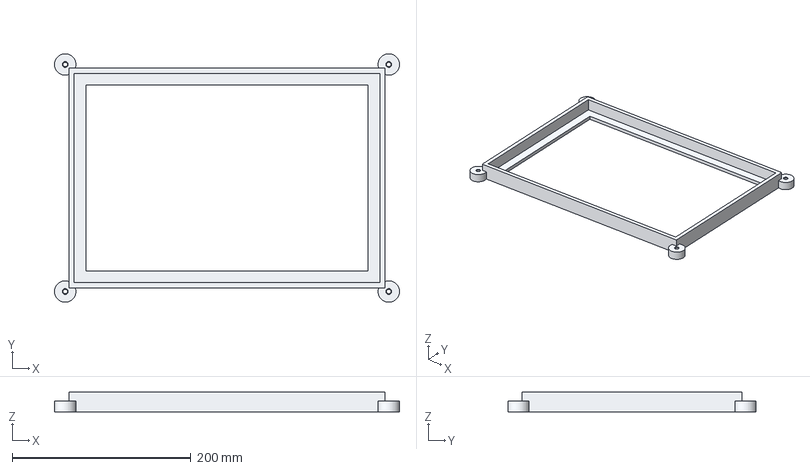
[picture p23: CAD file, 2026-10-14]
cad/solar_panel_frame/solar_panel_frame.step
386.0 x 278.0 x 22.0 mm
