grilledbiscuits/smartfeeder/cad/stl/cradle_rear.stl

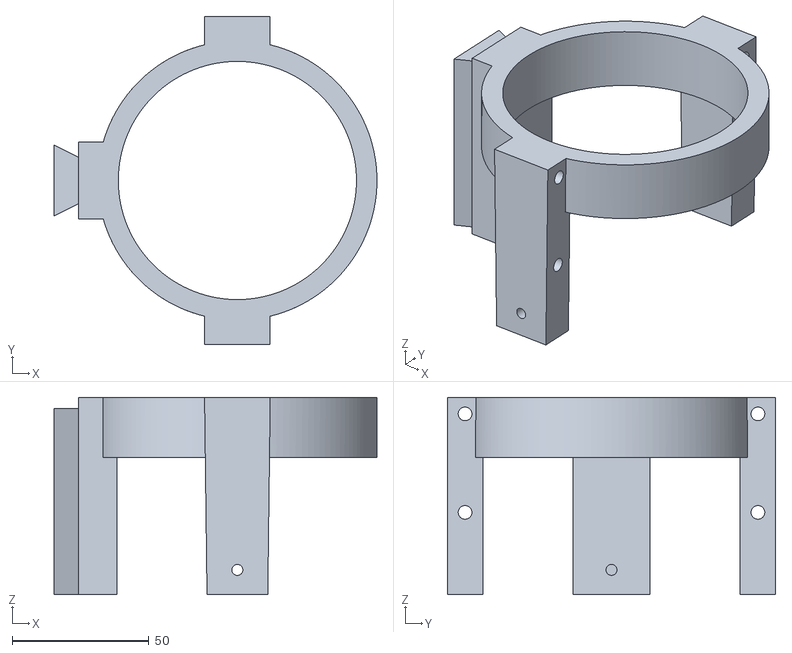
[picture p24: CAD file, 2026-10-02]
cad/stl/cradle_rear.stl
118.0 x 120.0 x 72.0
