grilledbiscuits/smartfeeder/(list of files, cad)

Other CAD files:
cad/step/rpi_housing.step
cad/stl/pmu_housing_lid_flat.stl
cad/stl/pmu_housing_roof_down.stl
cad/solar_panel_frame/solar_panel_frame_center_upper.step
cad/solar_panel_frame/solar_panel_frame_right_upper.step
cad/solar_panel_frame/solar_panel_frame_left_lower.step
cad/solar_panel_frame/solar_panel_frame_right_lower.step
cad/cradle/cross_pin_spine.stl
cad/solar_panel_frame/solar_panel_frame_center_lower.stl
cad/solar_panel_frame/solar_panel_frame_center_upper.stl
cad/solar_panel_frame/solar_panel_frame_left_lower.stl
cad/solar_panel_frame/solar_panel_frame_left_upper.stl
cad/solar_panel_frame/solar_panel_frame_plate_1.stl
cad/solar_panel_frame/solar_panel_frame_right_lower.stl
cad/solar_panel_frame/solar_panel_frame_right_upper.stl
cad/stl/cross_pin_beam.stl
