grilledbiscuits/smartfeeder/cad/cradle/cradle_assembled.png

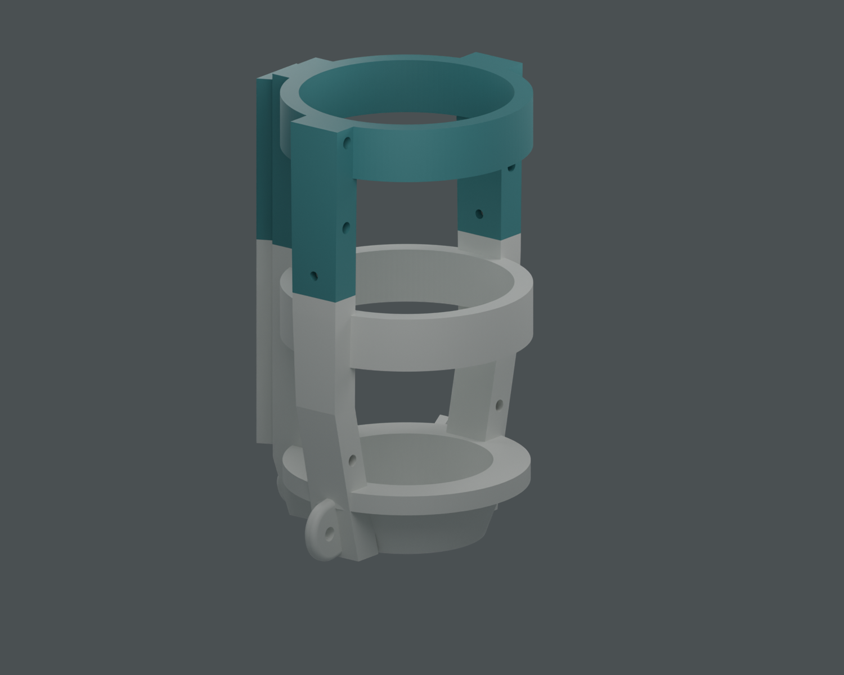
cad/cradle/cradle_assembled.png
