grilledbiscuits/smartfeeder/cad/docs/cradle_isometric_assembled.png

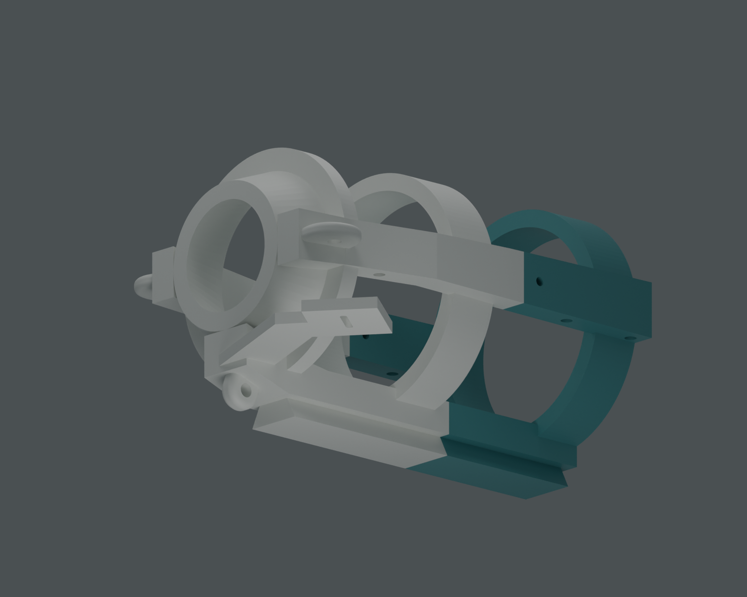
cad/docs/cradle_isometric_assembled.png
