grilledbiscuits/smartfeeder/cad/docs/pmu_full_print_preview.png

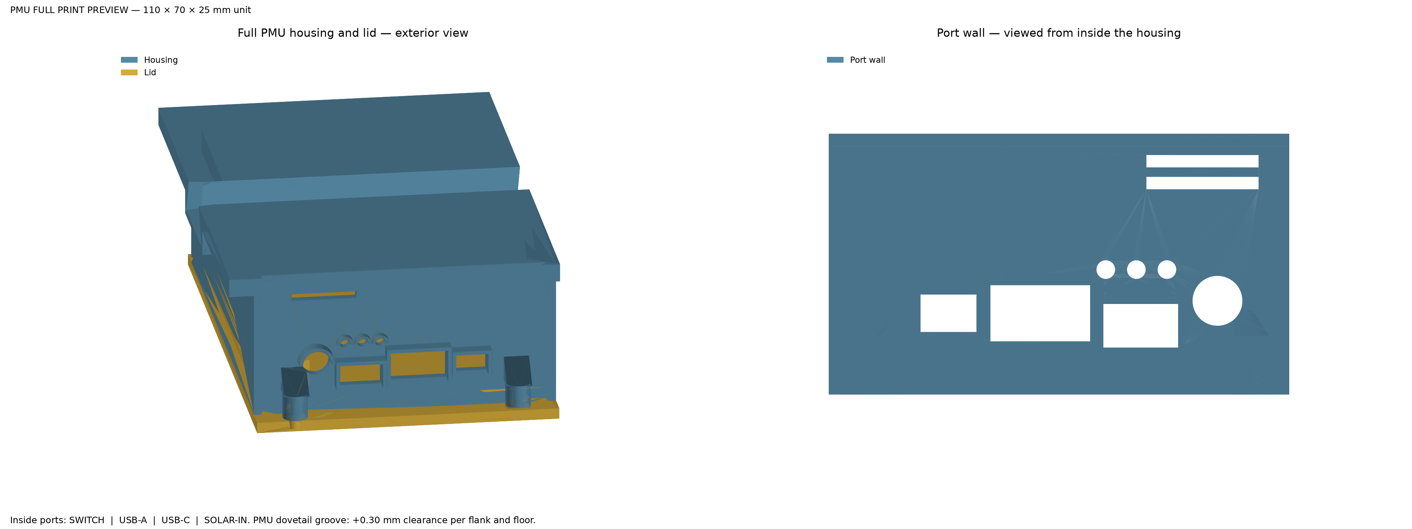
cad/docs/pmu_full_print_preview.png
