grilledbiscuits/smartfeeder/ml/config/train.yaml

# Training and runtime configuration.
# Everything here is read at runtime. No hyperparameter is hardcoded in Python.

version: 1

# =============================================================================
# COMPUTE
# =============================================================================
compute:
  # PHYSICAL core count, not logical. Measured on the dev machine: AMD Ryzen 5
  # 7520U, 4 cores / 8 threads. Setting torch threads to the logical count makes
  # CPU inference SLOWER through hyperthread contention on this workload.
  # Overridden automatically when running on Kaggle (see utils.runtime).
  torch_num_threads: 4
  # Kept low deliberately: the dev machine has ~2GB RAM free of 7GB total, and
  # each worker forks a copy of the dataset state.
  dataloader_num_workers: 2
  pin_memory: false
  seed: 20260731

# =============================================================================
# PATHS -- all relative to the repo root. No absolute paths anywhere.
# =============================================================================
paths:
  data_root: data
  raw_dir: data/raw
  processed_dir: data/processed
  quarantine_dir: data/quarantine
  manifest_db: data/manifest.sqlite
  manifest_parquet: data/manifest.parquet
  embeddings_dir: data/embeddings
  splits_file: data/splits.json
  reports_dir: reports
  checkpoints_dir: data/checkpoints
  taxon_cache: config/taxon_cache.json

# =============================================================================
# DATA ACQUISITION
# =============================================================================
fetch:
  # Licences we accept. Anything not on this list -- including images with NO
  # licence stated, and every ND / all-rights-reserved variant -- is excluded.
  # CC-BY and CC-BY-NC both REQUIRE attribution on downstream use, so the
  # manifest carries rights_holder and attribution_text for every image.
  allowed_licenses: [cc0, cc-by, cc-by-nc]

  # Contact email goes into the User-Agent, read from env var BIRDCAM_CONTACT.
  # Fetchers refuse to run without it: sending unidentified traffic at these
  # volumes is a good way to get blocked, and rightly so.
  contact_env_var: BIRDCAM_CONTACT
  user_agent_template: "birdcam/{version} (research; +{contact})"

  max_images_per_species: 1500   # cap the head of the distribution
  request_timeout_s: 30
  max_retries: 5
  backoff_base_s: 2.0

  inaturalist:
    enabled: true
    base_url: https://api.inaturalist.org/v1
    # iNat asks for ~1 request/second. Honoured, with backoff on 429.
    rate_limit_rps: 1.0
    quality_grade: research
    # MUST paginate with id_above: the API caps offset pagination at 10,000
    # results, and Tier A species exceed that.
    per_page: 200
    # Photo size to download. NOT `original`: originals run to 4000px and several
    # MB, we downsize to 256px short side anyway, and the dev machine has 28GB
    # free. `large` is capped at 1024px -- ample headroom over 256.
    photo_size: large
    # Controlled-term IDs are LOOKED UP from /v1/controlled_terms at runtime and
    # asserted against these known-good values (measured 2026-07-31). If the API
    # disagrees, that is a hard error -- it means the terms were revised and the
    # annotation mapping in taxonomy.yaml needs review.
    expected_terms:
      sex: { id: 9, values: { Female: 10, Male: 11, "Cannot Be Determined": 20 } }
      life_stage: { id: 1, values: { Adult: 2, Juvenile: 8 } }

  gbif:
    enabled: true
    base_url: https://api.gbif.org/v1
    rate_limit_rps: 4.0
    # Measured 2026-07-31: GBIF returns 6129 records for Cinnyris chalybeus in
    # ZA against iNaturalist's 6203, from dataset 50c9509d-22c7-4a22-a47d-
    # 8c48425ef4a7 -- which IS the iNaturalist research-grade export. GBIF is
    # therefore ~95% redundant for these taxa. Its value is the OTHER datasets,
    # so by default we skip the iNat mirror and let the iNat fetcher (which also
    # gets annotations) handle those records.
    exclude_dataset_keys:
      - 50c9509d-22c7-4a22-a47d-8c48425ef4a7   # iNaturalist research-grade
    # The async download endpoint needs a free GBIF account. At the volumes
    # measured (a few thousand per species, minus the iNat mirror) the search
    # API is sufficient, so we avoid the credential requirement entirely.
    use_async_download: false

  wikimedia:
    enabled: true
    base_url: https://commons.wikimedia.org/w/api.php
    rate_limit_rps: 2.0

  flickr:
    # Skips gracefully when FLICKR_API_KEY is absent.
    enabled: true
    base_url: https://api.flickr.com/services/rest/
    api_key_env_var: FLICKR_API_KEY
    rate_limit_rps: 1.0
    # Flickr licence IDs. Verified against flickr.photos.licenses.getInfo.
    # 0 = All Rights Reserved and every ND licence are excluded.
    allowed_license_ids: [1, 2, 4, 5, 7, 9, 10]

# =============================================================================
# PREPROCESSING
# =============================================================================
preprocess:
  short_side_px: 256          # HARD REQUIREMENT: decode cost dominates forward
                              # pass on a CPU-only machine.
  jpeg_quality: 90
  strip_exif: true            # orientation is APPLIED, then dropped
  phash_hamming_threshold: 4  # <= this counts as duplicate; keeps highest res

  split:
    train: 0.70
    val: 0.15
    test: 0.15
    # Grouped by observation AND observer. Photos of the same individual in one
    # burst must never straddle a split, or the metrics are fiction. Grouping by
    # observer additionally stops a single photographer's style leaking across.
    group_keys: [observation_id, observer_id]
    stratify_keys: [scientific_name, sex_plumage]

# =============================================================================
# BACKBONE
# =============================================================================
backbone:
  # --- fast-loop / local embedding extraction --------------------------------
  # Every iNat-2021 checkpoint in timm is ViT-L/336 or ConvNeXt-L (verified
  # against the HuggingFace hub 2026-07-31). Both are far too slow for CPU
  # embedding extraction here. So the LOCAL fast loop uses a mid-size CNN, and
  # its separability verdicts are a LOWER BOUND.
  local:
    name: convnext_tiny.in12k_ft_in1k
    pretrained: true
    image_size: 224
    batch_size: 8             # small: ~2GB RAM free on the dev machine
  # --- teacher (Kaggle GPU) ---------------------------------------------------
  # cache_embeddings.py is architecture-agnostic, so caching with the teacher on
  # Kaggle and downloading the .npy (20k x 1024 float32 ~= 80MB) gives the fast
  # loop teacher-grade features with no local GPU.
  teacher:
    name: vit_large_patch14_clip_336.laion2b_ft_augreg_inat21
    pretrained: true
    image_size: 336
    batch_size: 32
    # Fall back to ImageNet-21k and SAY SO IN THE LOG if the iNat checkpoint is
    # unavailable in the installed timm version. Never fail silently.
    fallback_name: convnext_base.fb_in22k_ft_in1k
  # --- student (deployment) ---------------------------------------------------
  # HAILO CONSTRAINT -- DO NOT CHANGE TO A TRANSFORMER.
  # The Hailo-8L Dataflow Compiler supports standard CNN ops well but has
  # limited and awkward support for ViT and ConvNeXt blocks (LayerNorm, GELU,
  # attention). A transformer student will either fail to compile or fall back
  # to CPU for large subgraphs, destroying the latency budget. Keep this a
  # plain CNN.
  # Selected by measurement, not by reputation. Full sweep 2026-08-01 over 9,318
  # Tier A images (reports/backbone_sweep.json), linear probe on frozen features:
  #
  #   backbone                      MACs   params  taxon   female
  #   tf_efficientnetv2_b0          0.72G   5.9M   0.734    0.577   <- selected
  #   efficientnet_b0               0.39G   4.0M   0.691    0.537
  #   mobilenetv3_large_100         0.21G   4.2M   0.690    0.495
  #   efficientnet_lite0            0.38G   3.4M   0.681    0.492
  #   mobilenetv4_conv_small        0.18G   2.5M   0.680    0.469
  #   mobilenetv4_conv_medium       0.83G   8.4M   0.670    0.478
  #   resnet50                      4.09G  23.5M   0.664    0.511
  #   convnext_tiny (Hailo-ineligible, ceiling)  4.46G  0.788  0.681
  #
  # +4.4pp taxon and +8.2pp female over mobilenetv3 for 3.4x the MACs. That
  # trade is worth taking because the absolute cost is negligible: 0.72 GMACs is
  # a rounding error for a Hailo-8L, and the Pi-side bottleneck is the camera
  # pipeline, not the accelerator. We classify sampled frames, not every frame.
  #
  # NOTE: resnet50 scores WORSE than mobilenetv3 at 20x the compute. More FLOPs
  # is not more accuracy -- which is exactly why this is measured.
  student:
    name: tf_efficientnetv2_b0
    pretrained: true
    image_size: 224
    batch_size: 64

# =============================================================================
# PHASE 5 -- FAST ITERATION LOOP
# =============================================================================
fast_loop:
  head_type: linear           # linear | mlp
  mlp_hidden: 512
  epochs: 60
  lr: 0.01
  weight_decay: 0.0001
  # Target <10s per run. That is what makes this project tractable on this
  # hardware, so it is a budget, not an aspiration.
  target_seconds_per_run: 10
  # Marginal accuracy gain per additional 100 images, per rare species.
  # Explicit output: it tells us where to spend labelling effort.
  learning_curve_fractions: [0.1, 0.25, 0.5, 0.75, 1.0]
  bootstrap_iterations: 1000  # for Wilson / bootstrap CIs on small classes

# =============================================================================
# PHASE 6 -- FULL TRAINING
# =============================================================================
train:
  # --- field footage -----------------------------------------------------------
  # Frames cut from feeder video, alongside the iNaturalist corpus. They are a
  # separate source with session-grouped splits, not manifest rows: see
  # src/birdcam/data/field_source.py.
  #
  # field_weight sets how much of a CLASS's signal comes from the feeder rather
  # than from the web. It is normalised within each class by the sampler, so it
  # never changes a class's share of the epoch -- see the note in _build_loaders.
  # Before that normalisation it silently shrank any class whose data is
  # field-only: `empty_feeder` was getting 0.73% of draws against a 2.70% target
  # for no reason except that no web alternative exists.
  #
  # 0.2, lowered from 0.3 on 2026-09-10 once the effective sample size was
  # measured. The independent unit in field footage is the CLIP, not the frame:
  # frames two per second apart are the same bird in the same pose.
  #
  #   class                     field frames   clips   web images
  #   Southern Double-collared         3,146      78        1,033
  #   Cape White-eye                     951      25          405
  #   Fork-tailed Drongo                 819       9        1,194
  #   Cape Bulbul                        313       4          400
  #
  # At 0.3 the Southern Double-collared class drew 48% of its training signal
  # from 78 bird-visits. At 0.2 it draws 38%, Cape White-eye 32%, and the rest
  # 12-14% -- meaningful in-domain signal without letting nine drongo visits
  # outvote 1,194 photographs.
  #
  # Still not derived: the honest range runs from ~0.03 (field's share of
  # INDEPENDENT samples) to 1.0 (its share of what the camera will actually
  # see), and no argument settles where in between. Each epoch now reports val
  # accuracy split by source, so the next run tunes this from evidence instead.
  use_field_frames: true
  field_weight: 0.2

  # 15, not 40. Fine-tuning a pretrained backbone on 12,776 images converges
  # long before 40 epochs and then overfits, and on this laptop each epoch costs
  # 16-23 minutes. Measured throughput (batch 8, CPU, 4 cores):
  #
  #   freeze_blocks  trainable  img/s  min/epoch  15 epochs
  #   6 (heads only)     0.34M   24.4        8.7      2.2 h
  #   4 (default)        5.52M   13.0       16.3      4.1 h
  #   2                  5.89M   11.6       18.4      4.6 h
  #   0 (full)           5.95M    9.4       22.6      5.6 h
  #
  # Note freezing 4 blocks saves only 7% of PARAMETERS but 28% of TIME:
  # EfficientNet's parameter mass is in the late blocks while its compute is in
  # the early, spatially-large ones. Freeze for speed, not for size.
  epochs: 15
  batch_size: 32
  lr: 0.0003
  weight_decay: 0.05
  optimizer: adamw
  scheduler: cosine
  warmup_epochs: 2
  label_smoothing: 0.1
  amp: true                   # ignored on CPU

  loss:
    taxon_weight: 1.0
    # DEMOTED 2026-08-04. Sex/plumage is a nice-to-have, not a requirement, so
    # the head is kept only for its regularising effect on the shared trunk and
    # for the bonus label when it happens to be right.
    #
    # It is NOT dropped entirely, for two reasons: a small auxiliary loss on a
    # correlated task is cheap regularisation, and the six-class output space is
    # already wired end to end -- removing it would be work now and work again
    # later if it ever matters.
    #
    # It no longer influences backbone selection, thresholds, or any headline
    # metric. If it degrades, that is acceptable.
    sex_weight: 0.1
    # Both implemented, both configurable, and Phase 7 reports which helped.
    use_focal: true
    focal_gamma: 2.0
    use_class_balanced_sampling: true
    class_balanced_beta: 0.999

  checkpoint:
    every_epoch: true
    resumable: true           # Kaggle sessions are capped at 12h
    keep_last_n: 3

  # --- augmentation ----------------------------------------------------------
  # Mimics real DEPLOYMENT failure modes, not just flip-and-crop. The domain gap
  # between clean field-guide photographs and a real feeder camera is the single
  # biggest technical risk in this project, and augmentation is the only lever
  # on it until real capture data exists.
  augment:
    hflip: 0.5
    rotate_deg: 12
    motion_blur: { p: 0.35, kernel_range: [3, 11] }      # birds move fast
    exposure_shift: { p: 0.4, brightness: 0.4, contrast: 0.35 }  # backlight
    occlusion_cutout: { p: 0.4, max_area_frac: 0.30 }    # head inside feeder port
    jpeg_artifacts: { p: 0.3, quality_range: [30, 75] }
    partial_crop: { p: 0.35, min_area_frac: 0.5 }        # bird half out of frame
    scale_jitter: [0.6, 1.0]

  tracking:
    # Weights & Biases if WANDB_API_KEY is set, else TensorBoard.
    wandb_project: birdcam
    wandb_api_key_env_var: WANDB_API_KEY
    tensorboard_dir: data/runs

# =============================================================================
# OPEN-SET FAILSAFE
# =============================================================================
# A softmax over the label space always returns one of its classes. Pointed at a
# squirrel, the classifier reports a bird -- often confidently. This layer lets
# the system answer "I don't know what that is", which is a different and more
# useful answer than a wrong species.
#
# The detector is fitted on IN-DISTRIBUTION TRAINING FEATURES ONLY and never
# sees an out-of-distribution example. Training it on known intruders would make
# it a closed-set classifier for those intruders and leave it helpless against
# the first novel one.
#
# Measured 2026-08-02, 18,146 target-bird images vs 2,486 real photographs of
# squirrels, mice, cats, rats, baboons, carpenter bees, honey bees, butterflies,
# agamas and skinks (config/ood.yaml), at a 5% false-alarm rate:
#
#   knn          AUROC 0.979   catches 90.9%   ~5MB,  2.6 MFLOPs   <- selected
#   energy       AUROC 0.927   catches 68.1%   free (logits only)
#   mahalanobis  AUROC 0.876   catches 29.2%   ~66KB, 1 matmul
#   max_softmax  AUROC 0.714   catches 17.8%   free (logits only)
#
# The naive confidence threshold (max_softmax) catches under a fifth. It is not
# an adequate failsafe on its own, which is the reason this section exists.
open_set:
  enabled: true
  scorer: knn
  knn_k: 10
  knn_max_reference: 1000
  # Operator-facing knob: the fraction of GENUINE bird frames we accept losing
  # in order to reject intruders. Calibrated on the validation split, never on
  # test. Raise it if squirrels are getting through; lower it if real visits are
  # being dropped.
  # Raised 0.05 -> 0.15 on evidence 2026-08-04. Visit-level false triggers by
  # novelty sensitivity, over 534 real bird visits and 540 OOD visits (visits
  # reconstructed from observation IDs -- genuine photo bursts):
  #
  #   FAR    bird visits fire   OOD visits fire
  #   2%           27.3%             2.8%
  #   5%           27.0%             0.9%
  #   15%          22.9%             0.4%
  #   20%          22.1%             0.0%
  #
  # Going from 5% to 15% removes three quarters of the remaining false triggers
  # and costs 4 percentage points of bird visits. Cheap. Beyond 20% the OOD rate
  # is already zero and further sensitivity only loses birds.
  target_false_alarm_rate: 0.15
  # Emitted when the novelty score clears the threshold. Distinct from
  # `uncertain` (rollup abstain): `unknown` means "not a thing I know about",
  # `uncertain` means "probably a bird, cannot pin it down". They deserve
  # different downstream handling -- uncertain visits are worth human review.
  unknown_label: unknown

# =============================================================================
# PHASE 8 -- EXPORT
# =============================================================================
export:
  onnx_opset: 17
  onnx_path: data/export/birdcam_student.onnx
  # --- calibration ------------------------------------------------------------
  # Confidence gates the video-capture decision, so a miscalibrated model is
  # worse than a slightly less accurate one. Measured 2026-08-01: the raw head
  # is ~2x overconfident (ECE 0.183). A single temperature fitted on the VAL
  # split -- never on test -- cuts that to 0.062 and leaves argmax, and
  # therefore accuracy, untouched.
  #
  # `temperature: null` means "fit it during export". A number here pins it.
  calibration:
    method: temperature
    temperature: null
    fit_split: val

  quantize:
    method: static            # INT8 post-training quantisation
    # Percentile, not MinMax. MinMax takes raw activation extremes and is
    # outlier-sensitive; Percentile clips the tails. Measured 2026-08-04 at 64
    # calibration images on 250 test images: Percentile +1.6pp, MinMax and
    # Entropy both -0.8pp against FP32.
    #
    # HONEST CAVEAT: at n=250 those 95% CIs overlap almost completely
    # (0.620-0.735 vs 0.595-0.712), so the three methods are statistically
    # indistinguishable here. Percentile is chosen because it is the
    # theoretically better choice for outlier-heavy activations and it did not
    # measure worse -- not because the data separates them.
    calibrate_method: Percentile
    # 64, not 500: ORT buffers every intermediate tensor across the whole
    # calibration set and hit 4.5GB resident at 500 images, which the Linux OOM
    # killer ended. Raise deliberately with --calib-size on a machine with RAM.
    # 64, not 500. ONNX Runtime buffers every intermediate tensor across the
    # whole calibration set (no incremental flush in 1.28), which reached 4.5GB
    # resident at 500 images and was ended by the Linux OOM killer on this 7GB
    # machine. 64 is below ORT's recommended 100-500 so ranges are noisier --
    # raise it deliberately with --calib-size where there is RAM to spare.
    calibration_size: 64
    # THE CALIBRATION SET MUST BE REAL FEEDER CROPS ONCE THEY EXIST.
    # Web images have a different noise, blur and exposure distribution to a Pi
    # camera at a feeder. Until real crops exist this stays `provisional` and
    # the export report says so on its face.
    calibration_source: provisional_web_subset
    # Fine-grained classification is unusually sensitive to INT8: nearly
    # identical classes sit close in feature space and quantisation smears them.
    # If the female classes degrade disproportionately, the report says so
    # loudly rather than reporting a single averaged delta.
    report_per_class_delta: true
    flag_threshold_pct: 2.0
