grilledbiscuits/smartfeeder/(commit log)

2026-07-31 Phase 1: repo scaffolding and validated config layer
    Config-driven skeleton for the two-head (taxon + sex/plumage) feeder-cam
    classifier. Phases 2-8 exist as placeholders that raise NotImplementedError
    rather than returning empty results.
    Grounded on live API probes (2026-07-31), which changed four design decisions:
    - No source annotates eclipse plumage. iNaturalist's Sex controlled term
    (id=9) has exactly Male/Female/Cannot Be Determined; GBIF's sex field is
    binary. Mapping annotated males to male_breeding would fabricate labels, so
    Head 2 keeps the six-class schema and trains annotated males with a masked
    partial-label loss over {male_breeding, male_eclipse}.
    - Promerops cafer i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
2026-08-01 Vertical slice: real Tier A scores end to end (Phases 2-5, narrow)
    Thin but genuine path from taxon resolution to measured accuracy, to put real
    numbers in front of the user before building the phases out in full.
    Implemented:
    - data/taxa.py GBIF + iNat resolution, cached; verifies derived genus and
    family against the backbone rather than trusting them
    - data/manifest.py SQLite manifest, resumable via per-species cursors
    - data/fetch_inat.py controlled terms looked up and asserted live; id_above
    pagination; strict licence filter; annotated observations
    fetched first because annotations are the scarce resource
    - data/prep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
2026-08-02 Backbone sweep, calibration, ONNX export; Tier A 0.684 -> 0.788
    Optimises Tier A accuracy and deployment cost together, on real measurements.
    Data: Tier A expanded 3,573 -> 9,318 images (0 download failures, 0 corrupt,
    68 pHash duplicates). Female test counts now 43-61 per species, at or near the
    n=50 threshold needed to state a conclusion.
    Backbone sweep (new src/birdcam/train/sweep.py), 8 candidates, cost reported as
    params/MACs because latency measured on an x86 laptop would not transfer to a
    Pi 5 + Hailo-8L:
    convnext_tiny 4.46G 0.788 taxon (Hailo-ineligible; ceiling)
    tf_efficientnetv2_b0 0.72G 0.734 <- new student
    mobilenetv3_large_100 0.21G 0.690 <- previous default
    r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
2026-08-04 Operating points: per-class confidence thresholds and false-trigger tuning
    Re-prioritised per instruction: sex prediction demoted to a bonus, focus moved
    to confidence quality on likely visitors and minimising false triggers.
    Architecture unchanged -- the Pi 4B vs Pi 5 decision is deferred and the export
    is board-neutral.
    New eval/thresholds.py fits per-class operating thresholds from real
    precision-recall curves on the validation split, and measures false triggers at
    the VISIT level rather than per frame. Visits are reconstructed from observation
    IDs, so a visit is a genuine photo burst of one individual by one photographer
    -- the closest available stand-in for a feeder visit.
    THE HEADLIN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
2026-08-04 Range prior for Rondebosch, calibration-order fix, INT8 quantisation
    RANGE PRIOR (data/range_prior.py, config/sites/rondebosch.yaml). Built from
    real iNaturalist observation density within 25km of Rondebosch -- 376 species,
    103,648 research-grade observations. Soft prior with a floor, never a filter:
    vagrants happen, and a model that cannot emit a rare species will never let you
    find one.
    Two findings from the local data:
    * Cinnyris chalybeus is the 2nd most-recorded bird within 25km (2,858 obs), so
    the most likely visitor really is the class the model handles worst.
    * Cinnyris afer has ONE observation within 25km. The brief lists it as Cape
    Town core, but locally it barely occurs -- w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
2026-08-04 Memory-safe INT8 quantisation; calibration method sweep
    The three "crashes" were the Linux OOM killer, not bugs. ONNX Runtime's static
    quantiser buffers every intermediate tensor across the entire calibration set
    (no incremental flush in 1.28); at 500 calibration images this reached 4.1-4.5GB
    resident on a 7GB machine and the kernel terminated python, taking unrelated
    processes with it. My inline commands had no memory ceiling and no
    checkpointing, so each kill lost the whole run.
    Fixed by changing the method, not retrying it:
    - calibration_size 500 -> 64 (documented as below ORT's recommended range)
    - _warn_if_memory_tight() estimates need against MemAvailable and warns first
    - results acc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
2026-08-04 Matched quantisation sweep: INT8 costs 3-5 points, calibration cannot fix it
    Resolves the open question in A24 with a controlled comparison -- identical
    800-image evaluation set, varying only calibration size:
    calib 32 0.6412 -> 0.6075 (-3.4pp)
    calib 64 0.6412 -> 0.5988 (-4.2pp)
    calib 500 0.6412 -> 0.5900 (-5.1pp, MinMax)
    Calibration size is not the explanation and neither is method. Across 32-500
    images and across MinMax and Percentile, INT8 costs 3.4-5.1 points. No setting
    in this range makes it free.
    The earlier +1.6pp "Percentile beats FP32" result was small-sample noise: it
    came from a 250-image evaluation whose 95% CI spans roughly +/-6 points. The same
    configuration o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
2026-08-04 Phase 6: end-to-end fine-tune, laptop-feasible and Kaggle-compatible
    train/train_full.py and train/augment.py. This is the module that can move the
    number that matters -- everything so far has trained a linear head on frozen
    ImageNet features, which caps confidence regardless of thresholds, priors or
    calibration (A20: only ~23% of bird visits clear a threshold).
    Measured throughput on this laptop (batch 8, CPU, 4 cores, 12,776 train images):
    freeze_blocks trainable img/s min/epoch 15 epochs
    6 (heads only) 0.34M 24.4 8.7 2.2 h
    4 (default) 5.52M 13.0 16.3 4.1 h
    2 5.89M 11.6 18.4 4.6 h
    0 (full) 5.95M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
2026-08-04 Fix OneCycleLR pct_start on short runs; record fine-tune memory profile
    pct_start was computed as warmup_epochs/epochs, which exceeds 1 on any run
    shorter than the warmup and made OneCycleLR raise. Harmless at the configured 15
    epochs, fatal for every smoke run -- caught by the memory-probe run before a long
    job was committed. Now clamped to [0.01, 0.3].
    Also records the measured peak memory of a full fine-tune: 1715 MB RSS at batch
    8 with freeze_blocks=0 and 2 workers, against ~2450 MB available. That is the
    figure that decides whether a run is safe here, and why batch size stays at 8
    with gradient accumulation instead of going larger.
    83 tests pass.
2026-08-05 Make evaluation read the trained checkpoint, not frozen embeddings
    eval/ loaded cached sweep embeddings and never read a checkpoint. That was
    correct while the only trained thing was a linear probe over those exact
    embeddings, and silently wrong the moment train_full.py fine-tuned the
    backbone: re-running the evaluation after a fine-tune refit a probe on the
    OLD features and reported it as the new model. Temperature, thresholds,
    novelty and quantisation would all have described a model nobody was going
    to deploy. Found by an external audit.
    - eval/extract.py: pooled features + both heads' logits from a checkpoint,
    keyed by ordered image IDs. The kNN novelty scorer needs those features
    a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
2026-08-05 Refit on the fine-tuned checkpoint: classification up, open-set broken
    First evaluation that actually measures student_best.pt.
    Classification improved on every axis. Temperature 2.332 -> 0.986, so the
    fine-tuned model is calibrated as trained. Per-class recall at the 80%
    precision target rose 10-29pp across all six Tier A species, and
    C. chalybeus -- which A20 said could not reach 80% precision at any
    threshold -- now reaches 0.833.
    Open-set detection went the other way. kNN novelty AUROC 0.979 -> 0.9032
    and its catch rate at 5% FPR 0.909 -> 0.431, because fine-tuning collapses
    the feature geometry a distance-based test depends on. End to end at 15%
    FAR that was nearly a wash: bird visits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
2026-08-16 Ignore ml/training/: field footage is tens of GB, far past GitHub limits
    Individual recordings reach 5.5GB against a 100MB per-file limit, and a
    'git add -A' would have tried to stage 21GB. Same reasoning as /ml/data/:
    the pixels are not the reproducible artefact, the extracted frames and
    their labels are.
2026-08-16 Record the double-collared pair as an unresolved group, not a species
    Renamed ml/training/southerndoublecollared -> doublecollared. The folder was
    labelled by eye and the label does not survive scrutiny.
    Blind identification on labelled corpus images, measured today: 15/20 overall
    for chalybeus vs afer, and 3/5 when no breast band is visible -- chance. Most
    frames in this folder are drab females and immatures carrying no band. The one
    clear male found across ten sessions shows a narrow band, favouring chalybeus,
    but it is head-down and one bird does not characterise 39 clips.
    So the folder mapping no longer asserts a species. FOLDER_TO_LABEL carries a
    FolderLabel with an explicit resolved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
2026-08-17 Fix two field-extraction faults found by running it for real
    A zero-byte JPEG killed an eight-hour overnight job. ffmpeg emitted one
    empty frame out of 11,051 at a clip boundary; PIL raised inside a DataLoader
    worker and took the process down seconds after extraction had succeeded.
    Frames are now verified where they are written, and unreadable ones are
    deleted and skipped. The check also runs on the resume path, so a run that
    died on a bad frame repairs itself by being re-run. One bad frame in eleven
    thousand should cost one frame, not the night.
    The frame glob was `{stem}_*.jpg`, but clip stems are prefixes of one
    another -- `20260816_143610` is a prefix of `20260816_143610_1` -- so the
    ba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
2026-08-17 Record A27: first measurement on real feeder footage
    11,050 frames from 155 minutes of video, scored with the fine-tuned
    checkpoint at the configured operating point.
    The headline inverts the project's working assumption. A hand count of 24
    random uncut frames found 10 with a bird against 14 empty -- roughly 42%
    bird-present -- while only 15.7% of the timeline would commit video. On real
    footage the system misses most birds; it does not record squirrels. Every
    false-trigger figure in this repo came from web photographs and pointed the
    wrong way.
    The capture allowlist is vindicated on real data: Cape Bulbul 98.1%
    identified, 0.0% recorded.
    Across 126 minutes of mostly-empty feeder the mode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
2026-08-27 Serialise the open-set failsafe so it can actually deploy
    capture/classifier.py accepts `scorer: knn` and then refuses, because the
    reference feature vectors were never written to disk (A26, external audit
    finding 3). Deployment therefore falls back to the energy scorer -- AUROC
    0.927 against kNN's 0.979 -- for want of a file. This writes that file, and
    the capture app now constructs a KNNScorer from it.
    Two things are deliberately not the obvious choice.
    Features come from the FROZEN backbone. Measured today on real footage, the
    fine-tuned feature collapse A25 recorded is worse than its AUROC suggested:
    novelty scores over 7,588 uncut frames spanned 0.565 to 0.649 against a 0.546
    threshol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
2026-08-27 Turn the open-set gate on, with a threshold measured on real footage
    The gate was off, so every frame was forced into one of the 62 taxon classes
    and a hand refilling the feeder came back as whichever sunbird it least badly
    resembled. `energy` needs no extra artefact -- it scores logits the graph
    already emits -- so this is a config change, not new code.
    Threshold -5.669, measured 2026-08-27 on 11,050 real feeder frames against the
    fine-tuned checkpoint: rejects 10% of real bird frames, flags 41.6% of
    continuous footage. Explicitly NOT the -8.4859 the old comments suggested;
    that came from the frozen-probe model scored against web photographs and gates
    almost nothing here. Same mismatch tha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
2026-08-27 Package the capture service and ship its systemd unit
    The capture package landed without the pieces that let it be installed. This
    adds them: a `capture` extra that pulls onnxruntime, pillow, pyyaml and flask
    but deliberately NOT picamera2 or gpiozero -- on Raspberry Pi OS Bookworm both
    come from apt, built against the system libcamera, and the venv is created with
    --system-site-packages to see them. capture/requirements-pi.txt is the on-device
    path; the extra is for everything else.
    pytest and ruff now cover capture/ as well, with the repo root on the path
    because the package imports `web` alongside `birdcam`.
    deploy/birdcam-capture.service was untracked, which mattered more than it
    looks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
2026-08-27 Carry the capture allowlist through the vote
    `vote()` rebuilt the Decision field by field and omitted is_capture_target, so
    it fell back to its default of False. `should_record` is
    `not is_unknown and is_capture_target`, which made it False for EVERY voted
    decision -- including a unanimous, high-confidence Tier A target:
    per-frame : cinnyris_chalybeus is_capture_target=True should_record=True
    voted : cinnyris_chalybeus is_capture_target=False should_record=False
    The capture service only ever reads the voted decision, so on a Pi this would
    have discarded every clip it ever recorded and published nothing, for weeks,
    without a single error in the log. Confirmed end to end aga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
2026-08-27 Correct the capture README where it no longer matches what ships
    Three claims had gone stale. The config table said novelty.enabled defaults to
    false; it is true, energy scorer at -5.669. The install step warned that the
    export does not match the calibration and the service will refuse to start;
    after re-exporting from student_best.pt it pairs and --check exits 0. The
    known-issues entry described the failsafe as off for want of serialised kNN
    artefacts.
    Replaces that entry with what measuring the gate on field frames actually
    found: it is on, it works on most footage, and it discards adult Amethyst
    Sunbird visits.
    uncut (500 random) 42.2% of frames flagged unknown
    double-colla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
2026-08-27 Add the end-to-end deployment runbook
    capture/README.md documents the capture service thoroughly, but a fresh Pi
    needs more than one service: the dashboard has no unit at all, the model
    artefacts do not travel with a clone, and the order of operations matters --
    `--check` has to pass before the sensor is ever armed.
    Written as procedure rather than explanation, and deliberately does not repeat
    the reasoning, which already lives in capture/README.md, reports/deployment.md
    and ASSUMPTIONS.md.
    Records the two things a first deployment carries knowingly. The graph is FP32
    where deployment.md calls INT8 mandatory on a Pi 4B CPU, because the INT8 file
    was quantised from the superseded export; it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
2026-09-10 Mine empty-feeder negatives from uncut footage, without the classifier
    The negative classes have never had a positive training example, and A27
    measured the consequence: across 126 minutes of mostly-empty feeder the model
    called a negative class 0.0% of the time, with the novelty gate absorbing empty
    frames instead. Using that model to find the examples would be circular, and
    after the Fork-tailed Drongo was added its head is the wrong width anyway.
    Instead: the feeder is bolted down and the camera fixed, so a per-session
    median over sampled frames reconstructs the empty scene even when no single
    frame is empty. Frames are then scored by how far they depart from it.
    Three attempts, each ve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
2026-09-10 Replace the stale RUNNING.md with current in-flight state
    It still described the 2026-08-04 fine-tune five weeks on. Now records the
    extraction in flight, that ml/training is symlinks into a USB drive that
    dangle if it is unmounted, that the August corpus is preserved rather than
    deleted, and the blocker that adding the Fork-tailed Drongo took the head from
    62 to 64 classes so the checkpoint no longer loads.
2026-09-10 Extract 22,213 frames from drive B; record where the negative miner stands
    Extraction complete and clean: 22,213 index entries, 22,213 unique paths,
    22,213 files on disk, zero frames dropped as unreadable. Roughly double the
    August corpus.
    uncut 13475 doublecollared 4499 (Southern Double-collared)
    whiteeye 1358 amethyst 1220
    drongo 1093 capebulbul 450
    multibird 75 hands 43
    The empty-feeder miner does WORSE on this footage than on August's, and the
    default drops from the 30th percentile to the 15th as a result:
    2026-08, bottom 30% 96% 1 of 24 sampled frames held a bird
    2026-09, bottom 30% 83%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
2026-09-10 Exclude sessions whose background is smeared by camera movement
    Verification of the 2026-09 empty-feeder candidates found failures that a
    threshold could not reach: the LOWEST-scoring third -- the "most definitely
    empty" frames -- included a large, plainly visible dark bird. Rendering the
    per-session median backgrounds showed why. Three sessions were recorded with
    the camera being moved, so the median smears across positions and departures
    from it mean nothing; one of those also has a bird baked into its background,
    because a bird occupied the port in most of the session's frames.
    Sessions are now gated on background sharpness against the frames they came
    from. Three of thirteen fail (2,956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
2026-09-10 Fetch the drongo, and fix what that exposed in splits and negative mining
    Fork-tailed Drongo had no images because it was never on the species list, not
    because iNaturalist lacks it: 5,259 ZA research-grade observations under CC0 /
    BY / BY-NC. Fetched 1,707, of which 1,686 survive dedup and are now split
    1194/247/246. The class is trainable, so the 62 -> 64 head no longer needs a
    name-keyed weight remap -- it can be trained from the fetched images instead.
    Two real bugs surfaced on the way.
    1. Splits were not independent across strata. One shared rng was consumed in
    sorted stratum order, so inserting "Dicrurus adsimilis" partway down the
    list changed the shuffle of every stratum sort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
2026-09-10 Add field frames as a second training source, weighted below the web corpus
    Option B: field frames keep their own index and their own session-grouped
    splits, and arrive as the same LabelledImage records the trainer already reads.
    They are not manifest rows, because the manifest describes iNaturalist
    observations -- licence, attribution, observer, source URL -- and a frame cut
    from feeder video has none of those. Forcing them in would mean a dozen columns
    that mean nothing and one, observer_id, that quietly lies.
    Splits are by recording session, which is stricter than it looks. Two clips
    from one session are the same bird in the same light minutes apart, and the
    empty-feeder frames mined fro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
2026-09-10 Gate empty-feeder frames on the port, and verify all 476 by eye
    The requirement was no contamination at all in the empty-feeder class, so the
    frames were reviewed individually rather than sampled. That review found a Cape
    White-eye plainly perched at the feeding port in a frame the miner had passed as
    empty -- and, worse, one the previous verification had also passed, because both
    were looking in the wrong place.
    Two compounding faults, both now fixed and both now tested.
    1. The whole-frame score cannot see a sunbird. The bird occupies a percent or
    two of the pixels while the tarp behind the feeder moves across all of them.
    Restricted to a tight box around the feeding port, the bird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
2026-09-10 Sex the field footage from the observer's own clip labels
    Field footage has no annotator, so every frame fell through to `indeterminate`
    -- which in this label space is a positive claim that the bird COULD NOT be
    sexed. On 4,499 frames of Southern Double-collared Sunbird, where the male has
    an iridescent green head and a red breast band and the female is plain
    grey-brown, that was not a missing label but a false one, and it trained the
    head to abstain on the easiest case it will ever see. Field frames supplied
    7,331 of the corpus's 13,547 `indeterminate` labels.
    141 clips labelled by the person who shot the footage. Sex is constant within a
    clip, so 141 decisions cover 5,719 frames. The lab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
2026-09-10 Second sexing pass, and honour the multi-bird markers in the clip names
    The first pass was collected with crops centred on the largest frame-to-frame
    change. In a cut clip the bird is present in most frames, so it is baked into
    the clip's own median and "most different" sometimes meant the wall behind the
    feeder or the glass bottle -- a card showing no bird at all. Recollected with
    crops centred on the FEEDING PORT, found by redness so a bird smeared into the
    median cannot move it, and six frames spread evenly through each clip instead
    of three chosen by a contaminated metric.
    Eleven clips changed, every one of them previously `unsure`: two double-collared
    resolved to male, six amethyst to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
2026-09-10 field_weight sets the mix inside a class, not the size of the class
    Measured before answering "what should it be", and the number was the smaller
    problem.
    `empty_feeder` and `other_animal` are field-only: there is no web alternative,
    so a 0.3 multiplier was not choosing a source mix for them, it was cutting their
    share of the epoch to a quarter of what class-balanced sampling had just
    decided. empty_feeder drew 0.73% against a 2.70% target, and Cape White-eye --
    the project's known hard confuser, 16% of C. chalybeus errors -- fell to 1.93%
    for no reason except that its data is in-domain. The sampler now normalises the
    source weight within each class, so class share is preserved exactly and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
2026-09-11 Decide emptiness geometrically; the classifier cannot do it
    The `empty_feeder` class does not work, and the diagnostic says why rather than
    how much:
    TRAIN 320 frames / 6 sessions recall 1.000 p(empty) 0.987
    VAL 81 frames / 1 session recall 0.000 p(empty) 0.001
    TEST 75 frames / 2 sessions recall 0.347
    Perfect on backgrounds it trained on, zero on one it had not seen -- and the
    test split's 75 frames are two sessions, of which it got one entirely right and
    one entirely wrong. It memorised nine backgrounds. That is the obvious shortcut
    when the class is defined by the ABSENCE of a subject: an empty-feeder frame is
    nothing but background, and 401 of them cannot out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
2026-09-11 Run the empty-feeder gate before the recorder, not after it
    Most triggers at a feeder are wind on the shade cloth. Until now every one of
    them was recorded, encoded, classified and then deleted. On a Pi 5 -- which has
    no hardware H.264 encoder, so encoding falls to software -- that is the largest
    avoidable load on the board, and it was being spent on frames with nothing in
    them.
    The gate already existed; it just ran inside the classifier, after the encode
    had already happened. Moving it ahead needs one new capability: grabbing a few
    frames WITHOUT starting an encode. `Recorder` gains an optional sibling protocol
    `FramePeeker`, implemented on the picamera2 recorder via capture_array (pulls
    f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
2026-09-16 Calibrate INT8 on field frames, and make the empty gate affordable on a Pi
    The board is decided: Raspberry Pi 4B, no accelerator. INT8 is now mandatory
    rather than an optimisation, so the export path is on the critical path.
    quantize.py has said since it was written that the calibration set must be real
    feeder crops once they exist, and called it the single highest-value
    substitution in the export path. It was still sampling web images only, because
    build_calibration_set called load_labelled without include_field -- it could not
    have picked a field frame if one existed. So could compare(), which measured
    quantisation damage on a distribution the device never sees.
    Both now include field fr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
2026-09-16 Measure latency on the actual Pi 4B; option A holds
    Measured on the target rather than estimated, because pyproject.toml is right
    that an off-target number is meaningless. Raspberry Pi 4 Model B Rev 1.5, 8GB,
    Debian 13 aarch64, onnxruntime 1.29.0, four threads, 75 seconds per
    configuration from a 39C start.
    int8 52.0 ms/frame p95 66.7 0.62 s per 12-frame clip
    fp32 88.8 ms/frame p95 93.3 1.07 s per 12-frame clip
    INT8 is 1.7x faster and 3.2x smaller for 2.1pp of field accuracy. A clip costs
    0.62s against motion events that arrive seconds apart at worst, so latency is
    not the binding constraint and the backbone does not need to change. Option A
    confirmed on evidence rather t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
2026-09-16 Gate on the recorded clip by default; a peek costs ~2 s on a Pi 4B
    Measured on the target with deploy/camera_check.py: peek() takes 1.76-2.03 s.
    The camera is stopped after every recording, so each peek restarts it and waits
    for it to settle. With the empty gate ahead of the recorder, every recording
    therefore began about two seconds after the PIR fired -- and a sunbird that
    sips for two or three seconds loses its arrival, or the whole visit.
    That placement was chosen while reasoning about a Pi 5, which has no hardware
    H.264 encoder, so skipping the encode was worth a delay. The board is a Pi 4B,
    which keeps its hardware encoder: recording is nearly free, and what the gate
    actually saves is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
2026-09-16 Add deploy scripts and record exactly where the Pi deployment paused
    Paused at the session limit before deploying, deliberately. A deploy cut off
    mid-swap over SSH would kill the remote script partway through and could leave
    the service unable to start, so nothing under /opt/smartfeeder was touched. The
    Pi is still running the August build, unchanged; today's code is staged apart
    from it at ~/birdcam-next.
    deploy/swap_in.sh backs up the live code, model, reports and config (never var/,
    never the venv), stops the service, installs the staged build keeping root
    ownership on code the service only reads, then runs `python -m capture --check`
    AS THE SERVICE USER before starting. --check builds e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
2026-09-16 Validate staged Pi capture and run documented isolated replay soak
2026-09-22 Build the empty-feeder background from quiet-period snapshots
    The rolling background learned from PIR-triggered frames, which assumes
    the foreground is a minority of what it sees. At a busy feeder it is not:
    observe an occupied frame often enough and the bird becomes the
    background, after which that bird is discarded as an empty feeder. Codex
    reproduced this on the synthetic scene.
    Its fix -- one verified reference frame -- cannot survive outdoors. The
    light moves all day, the frame stops matching by afternoon, and the gate
    silently never fires again. That is the safe direction, but with the gate
    off the classifier published all four empty replay clips as birds.
    So the background now comes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
2026-09-22 Quarantine pillarboxed field frames from fits, replays and metrics
    Some footage was filmed with the phone upright and extracted as 455x256
    frames with black bars over 68% of the width. 2844 of 9139 field frames
    are like this, and they were extracted, labelled and trained on without
    anyone checking the geometry. The deployment camera cannot produce bars,
    so these frames are a distribution the Pi never sees.
    They are not neutral. On the INT8 capture path, field validation scores
    0.933 on deployment framing and 0.793 on barred frames; Southern
    Double-collared drops 0.989 -> 0.877 on test, with 47 of 400 barred
    frames called other_animal -- which is exactly two of the five wrong
    actions in the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
2026-10-01 Add VL53L1X ToF motion sensor support as configurable alternative to HC-SR501
    - Implement ToFMotionSource class polling VL53L1X via I2C1 (GPIO 2/3)
    - Make motion.sensor_type config key selectable: pir | tof
    - Add ToF parameters: i2c_bus, i2c_address, detection_range_mm, read_rate_hz
    - Add Trigger.TOF event type to distinguish ToF-triggered clips in logs
    - Update config schema to require motion section with all parameters
    - Enable ToF as default in capture.example.yaml
    The capture pipeline remains sensor-blind; motion source is abstracted.
    Detection range (mm) is the primary tuning parameter per feeder installation.
2026-10-02 Add feeder CAD and target Raspberry Pi 4B
2026-10-03 Update feeder CAD housings and PMU rail clearance
2026-10-05 Add feeder component renders to CAD docs
2026-10-06 Finish the VL53L1X ToF motion source and declare its driver
    The ToF source landed in 789909b but imported a module that does not
    exist (`adafruit_circuitpython_vl53l1x.VL53L1X`), was never covered by a
    test, and its driver was not declared anywhere, so a Pi install could
    never have run it. The sensor on the feeder is a VL53L1X, not the
    HC-SR501 the deployed build still watches on GPIO4.
    - Import `adafruit_vl53l1x` and construct against `board.I2C()`, the
    names the published 1.2.x driver actually exposes.
    - Treat `distance` as CENTIMETRES and None as "no valid reading", and
    call `clear_interrupt()` so a new sample is produced each poll.
    - Fire once on entering `detection_range_mm` and re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
2026-10-06 Make the unit able to host the ToF path, and refit per-class thresholds
    Deploying the 37-class INT8 build surfaced three faults that had been
    latent because nothing had ever started the ToF path on the Pi.
    Unit file:
    - SupplementaryGroups gains i2c. /dev/i2c-1 is root:i2c, so without it
    the VL53L1X is unreachable; the service starts and then cannot see its
    sensor.
    - WorkingDirectory moves to a RuntimeDirectory systemd owns. lgpio, which
    Blinka reaches through RPi.GPIO, writes a .lgd-nfy* file into the CWD
    on import; /opt/smartfeeder is root-owned, so `import board` raised.
    The same write was already failing in the PIR path, where gpiozero
    swallowed it and silently fell back to i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
2026-10-06 Damp the ToF release so one visit is one trigger
    MEASURED at the feeder 2026-10-06: over 610 polls with a hand at the port,
    only 50% of reads returned a distance; the rest came back invalid. The
    VL53L1X reports "nothing in range" as an invalid reading too, so a dropout
    mid-visit is indistinguishable from the bird leaving. Releasing on the first
    one turned a single continuous presence into 44 triggers in 60 seconds, each
    recording and classifying an 8.5s clip.
    Raising detection_range_mm does not help -- it was never a distance problem.
    Measured over the same trace: 300mm gave 44 rising edges, 1300mm gave 45.
    Ignoring invalid reads instead would latch the trigger on forever, since an
    empty p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
2026-10-06 Release the ToF gate if it is held down, and say so
    A target parked in the beam holds the trigger permanently in range, and the
    feeder then stops recording with NOTHING in the log to distinguish that from
    a quiet afternoon. On 2026-10-06 that state was misdiagnosed twice from the
    logs alone, which is the argument for the valve: the symptom and a genuinely
    empty port are indistinguishable without it.
    The risk is concrete here. The perch sits about 20 cm from the sensor, well
    inside any sensible detection_range_mm, so it is only aim and the sensor's
    poor return off a thin rod that keep it from reading as a permanent target.
    A leaf, a web, or a few degrees of pointing drift would be enough.
    A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
2026-10-06 Narrow the ToF region of interest to keep the bottle out of the beam
    The sensor mounts beside the feeder bottle's neck, and with the full 16x16
    SPAD array the bottle reads a steady 13 cm -- NEARER than the perch at about
    20 cm. The VL53L1X reports one dominant return per reading, so the bird is
    masked behind the bottle and nothing downstream can recover it. Measured
    over the same scene, every detection_range_mm from 300 to 1300 behaved
    identically: always in range.
    Narrowing the window drops the bottle into the 239/247 corner of the array
    and leaves the centre clear. MEASURED 2026-10-06, three interleaved rounds
    per configuration, empty scene vs a target at the perch:
    16x16 c=199 2-17%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
2026-10-09 Let the novelty gate's rejects be kept, so it can be tuned
    First unattended run on the ToF trigger, 2026-10-06 16:26-20:00: 14 clips
    accepted, 23 dropped by cooldown, and every single clip rejected as unknown
    with novelty -3.81 to -4.80 against a -4.9434 threshold. Nothing published.
    All 14 were deleted on sight, so there is no way to tell a real bird the
    gate misjudged from a gust of wind -- the one question the run existed to
    answer.
    policy.py argued against retaining unknowns because "they are the bulk of
    the timeline (A27: 60.8% of uncut frames)". That was measured with a PIR on
    continuous footage. Under the ToF trigger the rate is 4 clips an hour, about
    190 MB a day against 105 GB free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
2026-10-09 Pin the camera's focus to the perch instead of one metre
    Camera Module 3 is an autofocus module, and picamera2 leaves imx708 in
    AfMode.Manual at LensPosition 1.0 -- one metre -- unless something sets it.
    Nothing ever did. Every clip this project has recorded was focused about
    nine times past the subject: sharp background, blurred bird. Nothing in
    capture/, ml/config/ or deploy/ mentioned focus at all.
    MEASURED 2026-10-09 by running continuous AF with a target at the perch and
    reading the lens back: it swept from 1.00 m and settled at 8.2-9.4 dioptres
    across 40 s, median 8.8 -> 0.114 m. That agrees independently with the ToF,
    which ranges the same target at 10-12 cm.
    The cost was not only s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
2026-10-09 Default the ToF region of interest back to the full array
    4x4 was committed in 980e348 as the setting that kept the feeder bottle out
    of the beam. It does, but it is only about 1.4 cm across at the measured
    0.114 m working distance, and on 2026-10-09 a confirmed Southern
    Double-collared Sunbird visit went COMPLETELY UNTRIGGERED at that width --
    no motion event at all. The bird was at the far end of the feeder.
    The error was in the evidence, not the arithmetic. 4x4 was validated against
    a human fist, which fills 1.4 cm comfortably; a sunbird does not, and nothing
    in that validation could have revealed the difference. First real Tier A
    visit, first false negative.
    Re-measured empty in SHORT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
2026-10-09 Log Pi health continuously for the deployment chapter
    There was no health record at all: temperature and throttle flags were only
    ever spot-checked by hand, and today's reboots fragmented the journal, so the
    soak evidence the write-up needs does not exist. This logs it to CSV from its
    own systemd service, so the record survives reboots and is independent of the
    capture service's log rotation.
    WHAT IT DELIBERATELY DOES NOT CLAIM: power. A Pi 4B has no onboard power
    sensor, so watts are unobtainable in software at any sample rate. core_volt
    is the SoC core rail, not input power, and the throttle bits only say whether
    the 5 V input sagged past the undervoltage threshold. Real consumption needs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
2026-10-09 Keep the ToF cone wide: a missed visit is worse than a discarded clip
    Three ROI widths in one afternoon, measured against observed sunbird visits:
    4x4 (~1.4 cm at 0.114 m) missed a visit outright
    8x8 (~2.8 cm) caught one, missed another
    16x16 (full ~27 deg cone) ~1.5 triggers/min on an EMPTY port
    I narrowed twice to suppress those empty-port triggers, which was the wrong
    call: every one of them was scored `unknown` by the novelty gate and
    RETAINED, not published. Not one became a false visit record. The only false
    publish all day was a human hand at close range, which happens at any width.
    So the costs are not comparable. A false trigger costs a discarded clip, some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
2026-10-09 Record the 2026-10-09 field commissioning as citable ground truth
    The session that found the focus fault produced measurements that exist
    nowhere else, and the observations behind them came from a person watching
    the feeder -- they cannot be reconstructed from logs later.
    deploy/field-log-20261009.md
    Narrative record with the method stated for each measurement: the focus
    fault and its effect on novelty energies, the three ROI widths against
    observed visits, the hand false positive, the two trigger-source defects,
    and thermal/resource telemetry.
    deploy/field-log-20261009-observations.csv
    One row per event with an INDEPENDENT ground truth -- a human saw what was
    there, or the tri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
2026-10-09 Promote the 14:35 sunbird to observer-confirmed ground truth
    The user confirms watching the Southern Double-collared Sunbird visit at
    14:35:51, so it is no longer a system-only detection. That matters because the
    whole point of the observation log is that a row counts as ground truth only
    when something other than the system vouches for it -- there are now no
    system_only rows left, and a check asserts it.
    The observed-visit set becomes four, of which two produced a trigger. The
    summary is now a per-visit table rather than a row count, because rows and
    visits differ: the Cape White-eye occupies two rows, one per threshold
    condition, and counting rows overstated the denominator.
    Still not a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
2026-10-09 Trigger on departure from the resting distance, not an absolute range
    motion.detection_range_mm asked "is anything within 500 mm?" and the perch is
    bolted in the beam at ~13 cm, so the answer was permanently yes: the gate
    latched on the first poll after start and a bird landing on it produced no
    rising edge. Every absolute range behaved identically (300 mm gave 44 edges,
    1300 gave 45), which is the signature of this fault rather than of a badly
    chosen threshold.
    Two things that looked like fixes were symptoms. Narrowing roi_size suppressed
    the empty-port triggers by aiming the beam away from where birds land, costing
    two observed visits; max_hold_seconds, added to log a stuck gate, became t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
2026-10-09 Calibrate ToF baseline trigger on the Pi
2026-10-10 Fit the ToF margin through poll_once, not a reimplementation of it
    tof_baseline.py hand-rolled the trigger state machine in its replay loop and
    left out max_hold_seconds. A replayed gate therefore latched on its first
    detection and never re-armed, reporting exactly 1 event for every margin from
    5 to 15 mm. That reads as "quiet" and means "stuck".
    Both margin fits to date came from this. The 7 mm value deployed on 2026-10-09
    and the 20 mm the script recommended this morning are artifacts, not
    measurements, which is why the script's 1.1 events/min disagreed by 6x with the
    6.7/min the live service was actually producing on an empty feeder.
    The replay now feeds a recorded trace through the rea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
2026-10-10 Fit the ToF margin at 10 mm and log the departure that fired
    Refit against the corrected harness, 180 s empty-scene trace at the feeder in
    SE wind, replayed through the real poll_once:
    resting distance median 118 mm, stdev 3.0 mm, p1 113, p99 129
    5 mm -> 15.7 false triggers/min
    7 mm -> 5.2 (agrees with the 6.7/min the live service was producing)
    8 mm -> 2.1
    10 mm -> 0.3 the knee
    15/20/30 mm -> 0.3, one near-side outlier at 73 mm fires at any margin
    The 3.0 mm stdev supersedes the 6.6 mm from this morning's 60 s sample; that
    window was too short. 10 mm cuts false triggers 17x and nothing above it buys
    anything.
    The upper bound is still open and is the real risk. The only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
2026-10-10 Record that birds read farther than baseline, not nearer
    The departure log settled a question the code comments had been guessing at.
    Both triggers in the first three minutes at 10 mm were real birds and both
    departed in the POSITIVE direction: Cape White-eye +13 mm (published, species,
    0.880, novelty -6.69) and Cape Bulbul +11 mm (correctly discarded, not a
    capture target), against a 118 mm baseline. The 2026-10-09 hand test agrees at
    +11 mm.
    The resting return is the near furniture; a body at the port scatters the beam
    so the dominant return comes from behind it. The nearer-only margin those
    comments proposed as an optimisation would have missed both birds, so the note
    claiming birds read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
2026-10-10 Track the ToF baseline over all readings in a 120 s window
    Two defects, both found by an observer-confirmed visit that the system missed.
    A 3 s initial window is smaller than a bird. The service was restarted at
    10:30:41 for an unrelated deploy while a confirmed Southern Double-collared was
    at the feeder, and learned 126 mm from 30 readings OF THE BIRD. The comment
    claiming a bird could not enter the baseline was wrong: the exclusion it relied
    on tests whether the gate is detected, and during the first learn there is no
    baseline to detect against, so whatever is at the port defines "empty". The
    clip that followed at 10:30:48 was triggered by the bird LEAVING, scored
    unknown, and retained. O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
2026-10-10 Correct the record: the 10:30:27 visit was published, not missed
    ff929fd recorded the observer-confirmed Southern Double-collared at
    2026-10-10T10:30:27 as a false negative and claimed the restart at 10:30:41
    destroyed it. Both claims are false. The operator caught it:
    10:30:27 motion admitted
    10:30:36 recorded 8.6s
    10:30:38 publish: cinnyris_chalybeus (species) conf=0.829
    10:30:39 publish confirmed, visit_id=24
    10:30:41 restart
    The visit published two seconds before the restart, at species level, novelty
    -6.1021, clearing the threshold by ~1.2. Now recorded as the TP it is, and the
    first observer-confirmed visit on the 10 mm margin.
    The error was method, not interpretation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
2026-10-10 Rewrite the baseline-window rationale around what was measured
    The comments deployed with the 120 s window asserted that the service learned
    126 mm from a bird and that this cost a confirmed visit. Neither happened: the
    visit published as visit_id=24 two seconds before the restart, and the claim
    came from a log query truncated with `tail -14`. Left in place, that text would
    have reached the report as a finding.
    Also removed: the 118 -> 131 mm "ratchet". That is 5 mm of wander in a 3 s
    median against a scene with 3.0 mm stdev, which is jitter.
    What the window actually rests on, against the 118 mm resting median measured
    from a 180 s raw trace:
    30 samples (3 s) -> learned 126 mm, 8 mm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
2026-10-10 Record the confirmed Amethyst visit and re-measure the departure direction
    Operator-confirmed Amethyst Sunbird, visit 26 at 10:43:35, published at species
    level with confidence 0.714 against a per-class threshold of 0.43. ToF departure
    +13 mm (134 mm against a 121 mm baseline) on a 10 mm margin. Visit 25 at
    10:42:36 is the same bird 59 s earlier at 0.807 and +11 mm, system-reported
    only, recorded as such and not as a second ground truth.
    A34's direction claim now has evidence behind it. Every departure logged on
    2026-10-10 was positive -- +11, +13, +38 mm, no exceptions -- and the two bird
    figures were measured against a baseline independently corroborated at
    117-118 mm. The figures the ent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
2026-10-10 Both Amethyst publishes are operator-confirmed; finish the A34 edit
    The operator confirmed visit 25 as well as visit 26, so both Amethyst publishes
    on 2026-10-10 are ground truth, not one confirmed and one system-reported:
    visit 25 10:42:36 conf 0.807 departure +11 mm (128 vs baseline 117)
    visit 26 10:43:35 conf 0.714 departure +13 mm (134 vs baseline 121)
    They are 59 s apart and may be one individual returning, so they are two
    correct PUBLISHES and not necessarily two independent visits. Recorded that way
    rather than as two visits.
    Visit 25 is the narrowest confirmed detection on record: +11 mm against a 10 mm
    margin clears it by 1 mm. Amethyst at species level was the model's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
2026-10-10 Record the 2026-10-10 run: six publishes, six confirmed, no observed misses
    The first session where trigger, focus, classifier, gate and allowlist all
    worked at once across multiple visits. One fixed configuration: ToF
    baseline-relative at 10 mm, 1200-sample median, full 16x16 ROI, lens_position
    8.8, energy threshold -4.9434.
    23 10:27:21 Cape White-eye 0.880 -6.69 --
    24 10:30:27 Southern Double-collared 0.829 -6.10 --
    25 10:42:36 Amethyst Sunbird 0.807 -6.39 +11 mm
    26 10:43:35 Amethyst Sunbird 0.714 -6.76 +13 mm
    27 10:45:56 Cape White-eye 0.920 -7.49 +43 mm
    28 10:50:31 Cape White-eye 0.891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
2026-10-10 Record confirmed visit 29; seven of seven correct
    Cape White-eye, 10:52:45, operator-confirmed. Visit id 29, confidence 0.897,
    novelty -7.5596 (the most familiar clip of the day), ToF departure +12 mm
    (130 mm against a 118 mm baseline).
    Section 7a and the negative observation now span 10:27:21-10:52:45: seven
    publishes, seven operator-confirmed correct, no observed misses. Still no rate,
    for the reasons already recorded.
    Confirmed bird departures now span +10 to +43 mm. The +10 mm fires only because
    the comparison is >=, so a bird departing +9 mm would be invisible and would
    produce no log line of any kind.
    CSV: 17 rows, 10 TP, 3 FN, 3 correct rejections, 1 FP.
2026-10-10 Record confirmed visit 30; eight of eight correct
    Cape White-eye, 11:00:20, operator-confirmed. Visit id 30, confidence 0.9115,
    novelty -7.2790, ToF departure +26 mm (144 mm against a 118 mm baseline).
    Section 7a and the negative observation now span 10:27:21-11:00:20: eight
    publishes, eight operator-confirmed correct, no observed misses over 33 minutes.
    Still no rate, for the reasons already recorded. Also corrects a stale count
    left in 7a by the visit-29 edit, which updated the heading but not the sentence
    below the table.
    Also logged: the first negative departure on a stable baseline, -10 mm at
    10:54:52 (109 mm against 119 mm), which scored unknown at novelty -4.5503 and
    was retained. O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
2026-10-10 Record confirmed visit 31; nine of nine correct
    Southern Double-collared Sunbird, 11:03:05, operator-confirmed. Visit id 31,
    confidence 0.8556, novelty -6.5625, ToF departure +17 mm (135 mm against a
    118 mm baseline). The sex_label came back "indeterminate" and is not
    observer-confirmed, so it is recorded but not counted as correct.
    Section 7a and the negative observation now span 10:27:21-11:03:05: nine
    publishes, nine operator-confirmed correct, no observed misses over 36 minutes,
    across three species. Still no rate, for the reasons already recorded.
2026-10-10 Record the sex head's first ground truth: indeterminate on a confirmed male
    Visit 31 predicted sex_label=indeterminate for the Southern Double-collared
    Sunbird at 11:03:05. The operator reports a male.
    That is an error rather than a cautious abstention. taxonomy.yaml is explicit
    that indeterminate is a first-class prediction meaning the bird COULD NOT be
    sexed from the image -- it exists so the head learns to make that claim instead
    of treating unannotated images as missing data, and monomorphic_forced_na exists
    to stop the head being trained on species where the claim would be vacuous. So
    the model asserted unsexability about a dimorphic species photographed in sharp
    focus at 0.114 m.
    Thi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
2026-10-10 Record visit 32 and a confirmed visit lost to the 30 s cooldown
    Visit 32: Southern Double-collared Sunbird, 11:08:21, operator-confirmed species
    and sex (male). Confidence 0.8887, novelty -6.6515, ToF departure +10 mm (127 mm
    against a 117 mm baseline) -- joint-narrowest confirmed detection, firing only
    because the test is >=. Predicted male_eclipse, so the sex head is now 2 of 3,
    with both male calls landing on eclipse in breeding season.
    Then a confirmed Cape White-eye arrived immediately after it and was LOST:
    11:08:21 +10 mm admitted -> visit 32, published
    11:08:33 +12 mm dropped_cooldown since_last_admit_s=12.5
    11:08:42 +21 mm dropped_cooldown since_last_admit_s=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
2026-10-10 Record visit 33 and the empty gate's marginal rejections
    Visit 33: Cape White-eye, 11:17:33, operator-confirmed. Confidence 0.885, ToF
    departure +34 mm (151 mm against a 117 mm baseline).
    Also recorded: three ToF triggers between 11:11 and 11:17 that were recorded and
    then discarded by IdleBackgroundGate as "feeder empty, not classified", at
    departures of +13, -10 and +10 mm. All three sit within 3 mm of the margin.
    That is the layered argument in section 2 working: the trigger is generous and
    precision is recovered downstream, and the marginal firings are exactly the ones
    the empty gate catches. It also costs less than the unknown path -- the gate
    rejects before the model runs, where an u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
2026-10-10 Record visit 34, and what the cooldown is actually for
    Visit 34: Southern Double-collared Sunbird, 11:23:04, operator-confirmed species
    and sex (male). Confidence 0.8666, novelty -6.5189, ToF departure +11 mm (129 mm
    against a 118 mm baseline). Predicted male_eclipse, so the sex head is 3 of 4 --
    its one failure, visit 31's indeterminate, now sits between two correct male
    calls on the same species 20 and 5 minutes either side of it.
    Visit 34 also produced six dropped_cooldown edges in the following 18 s, at 1.3,
    7.1, 10.4, 11.6, 13.1 and 17.6 s, departures +10 to +15 mm. One bird, one visit,
    seven rising edges.
    That belongs beside the loss at 11:08:33. The same 30 s window cost one
    confirm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
2026-10-10 Record visit 35 and the departure sign asymmetry at n=29
    Visit 35: Cape White-eye, 11:24:13, operator-confirmed. Confidence 0.9312 and
    novelty -7.6988, the strongest clip of the day. ToF departure +11 mm.
    sex_label=not_applicable, which is correct -- Zosterops virens is on
    taxonomy.yaml's monomorphic_forced_na list, so the forced-NA mechanism is
    confirmed working in the field.
    Every rising edge from 10:54 to 11:24, by signed departure: 21 positive, 8
    negative.
    +10:6 +11:5 +12:3 +13:2 +15:1 +17:1 +21:1 +26:1 +34:1
    -10:4 -11:3 -12:1
    Two things follow and both support A34. Every confirmed bird was positive -- no
    publish in this project has come from a negative departure. And th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
2026-10-10 Record confirmed visit 36; fourteen of fourteen correct
    Cape White-eye, 11:30:10, operator-confirmed. Visit id 36, confidence 0.8971,
    novelty -6.8948, ToF departure +14 mm (132 mm against a 118 mm baseline).
    sex_label=not_applicable, correct for a monomorphic_forced_na species.
    Section 7a now spans 10:27:21-11:30:10: fourteen publishes, fourteen
    operator-confirmed correct, one confirmed visit lost to the cooldown, over 63
    minutes. Still no rate, for the reasons already recorded.
2026-10-10 Add the missing visit 23 row, and flag that half the day is uncalibrated
    Audit found visit 23 (Cape White-eye, 10:27:21, conf 0.880, novelty -6.6931,
    departure +13 mm) had no CSV row. The operator's confirmation covered visits 23
    and 24 and only 24 was recorded. Today's tally is 8 Cape White-eye, 4 Southern
    Double-collared, 2 Amethyst = 14.
    The operator notes Cape White-eye is a TEMPORARY 7th Tier A, which materially
    changes how the day's headline reads and was recorded only in section 7 and the
    "should not claim" list, not in 7a where the result itself lives. 7a now carries
    it:
    Cape White-eye 8 publishes Tier C, temporary, Pi-local, uncommitted
    S. Double-coll. 4 publishes Tier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
2026-10-10 Deploy the whole tree, stamped with its commit
    Hand-copying individual files into /opt/smartfeeder is how a threshold came to
    sit in the deployed ml/config/taxonomy.yaml while the inference.py that reads it
    stayed behind -- a silent no-op for a whole field run, and a clip published that
    it would have held back (A35). deploy/swap_in.sh already did the hard half
    correctly: backup, stop, rsync --delete of every code dir, validate with
    python -m capture --check as the service user, watch the log, roll back on any
    error. It was missing a staging half, so nothing ever used it.
    deploy/push.sh is that half, run from the repo root:
    bash deploy/push.sh stage HEAD to the Pi, then swap in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
2026-10-13 Add fsynced Pi battery runtime logger
2026-10-14 Record first Pi battery idle discharge
2026-10-14 Document full-charge battery idle power estimate
2026-10-14 Prepare durable timed inference battery test
2026-10-14 Add solar frame print plate and organize CAD by component
2026-10-15 Archive inference battery run and prepare camera discharge
2026-10-16 Archive camera inference battery discharge results
2026-10-17 Archive repeat idle battery discharge results
